Wet-Lettuce-Robocup/robot_pcb/README.md

# Wet Lettuce Robot PCB

Kicad design file for the Wet Lettuce RoboCup Junior International robot.
