Wet-Lettuce-Robocup/robot_pcb/3dmodels/B2PS-VH_LF__SN_.stp

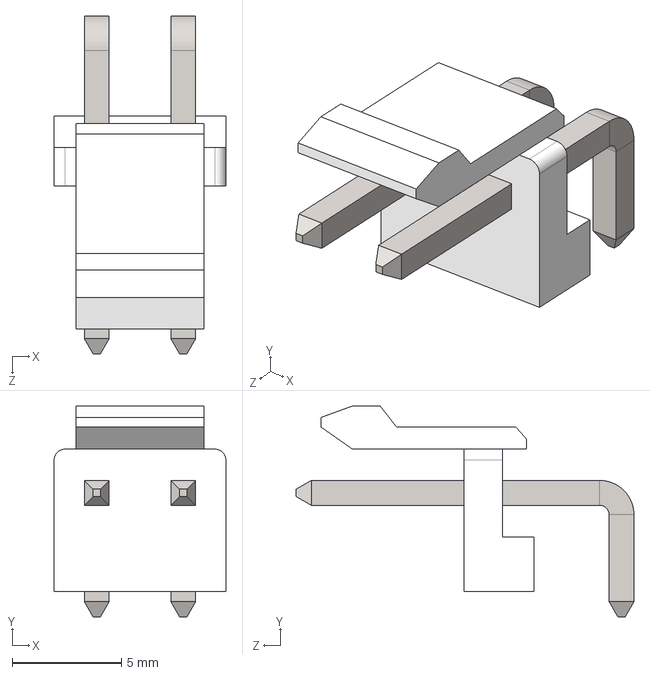
[picture p1: CAD file, 2026-03-14]
3dmodels/B2PS-VH_LF__SN_.stp
7.86 x 9.66 x 15.5 mm
