Wet-Lettuce-Robocup/robot_pcb/frontleds/frontleds.step

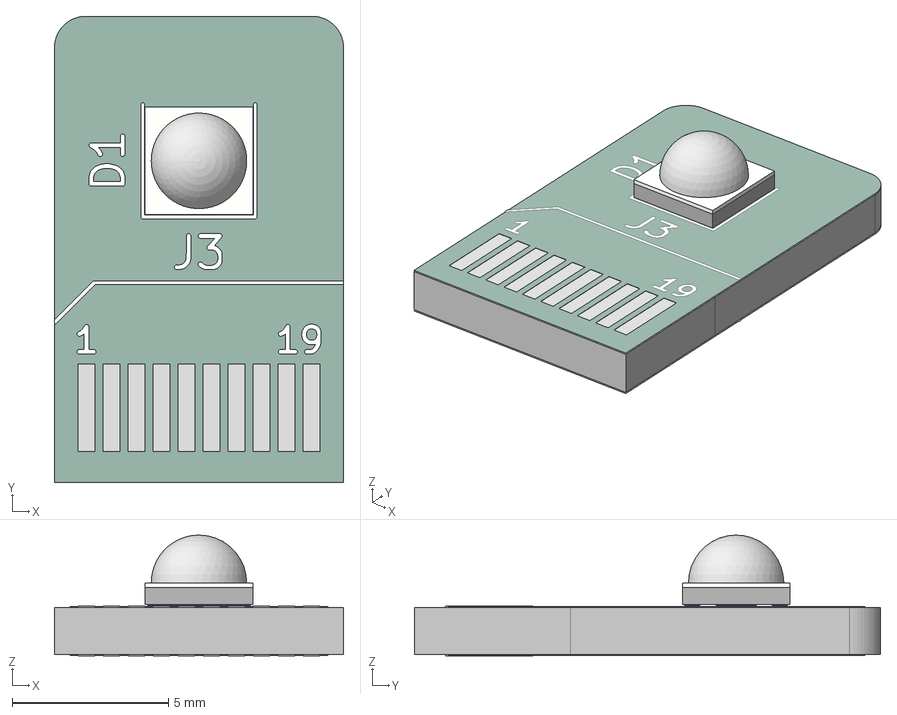
[picture p2: CAD file, 2026-03-14]
frontleds/frontleds.step
9.25 x 14.9 x 3.90 mm
LED_Cree-XP-GWT
frontleds_copper
frontleds_pad
frontleds_via
frontleds_silkscreen x 2
frontleds_soldermask x 2
frontleds_PCB
