Wet-Lettuce-Robocup/robot_pcb/3dmodels/MF-RG900-2.stp

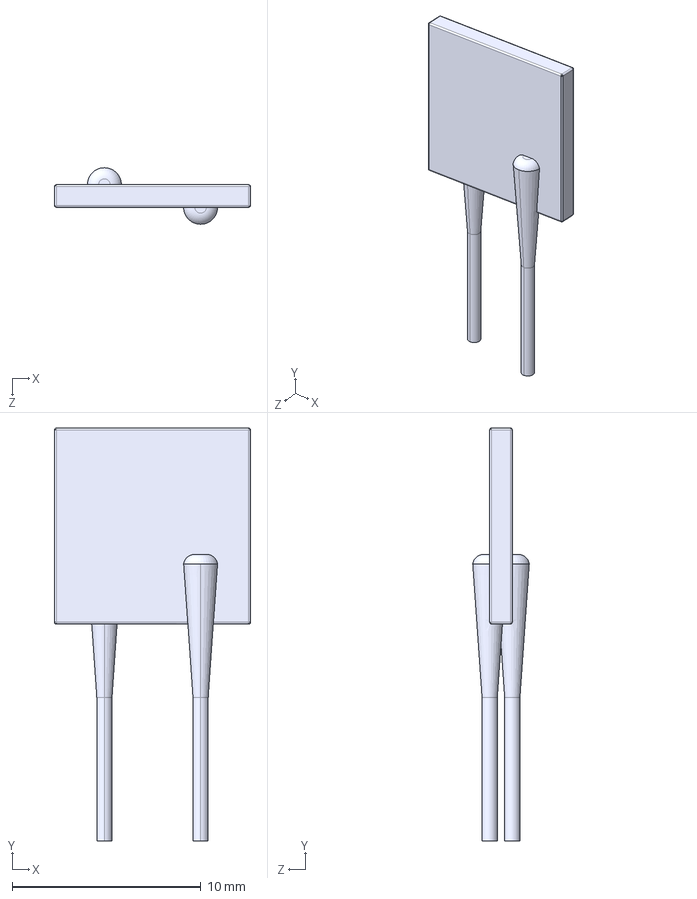
[picture p3: CAD file, 2026-03-14]
3dmodels/MF-RG900-2.stp
10.4 x 21.9 x 3.00 mm
