Wet-Lettuce-Robocup/robot_pcb/3dmodels/MF-RG900-0.stp

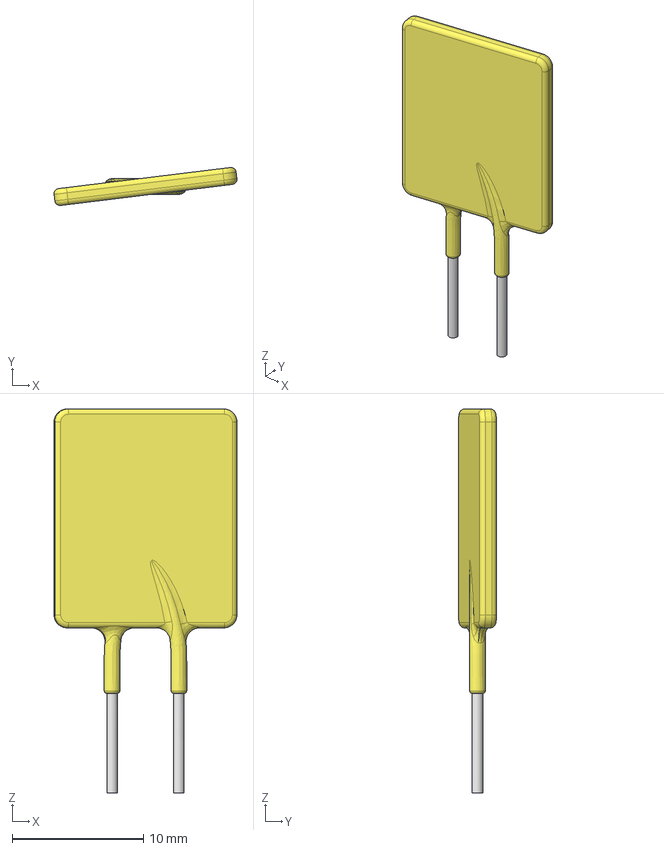
[picture p4: CAD file, 2026-03-14]
3dmodels/MF-RG900-0.stp
14.0 x 2.90 x 29.3 mm
