Wet-Lettuce-Robocup/robot_pcb/3dmodels/STCS1APUR.stp

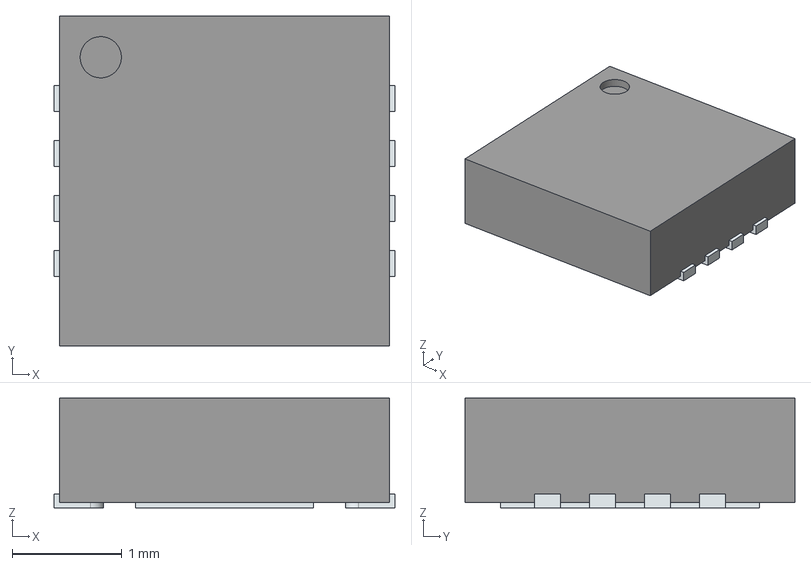
[picture p5: CAD file, 2026-03-13]
3dmodels/STCS1APUR.stp
3.10 x 3.00 x 1.00 mm
ThermalPin
PinsArrayLR
