Wet-Lettuce-Robocup/robot_pcb/3dmodels/HSEC8-110-01-S-DV-A.stp

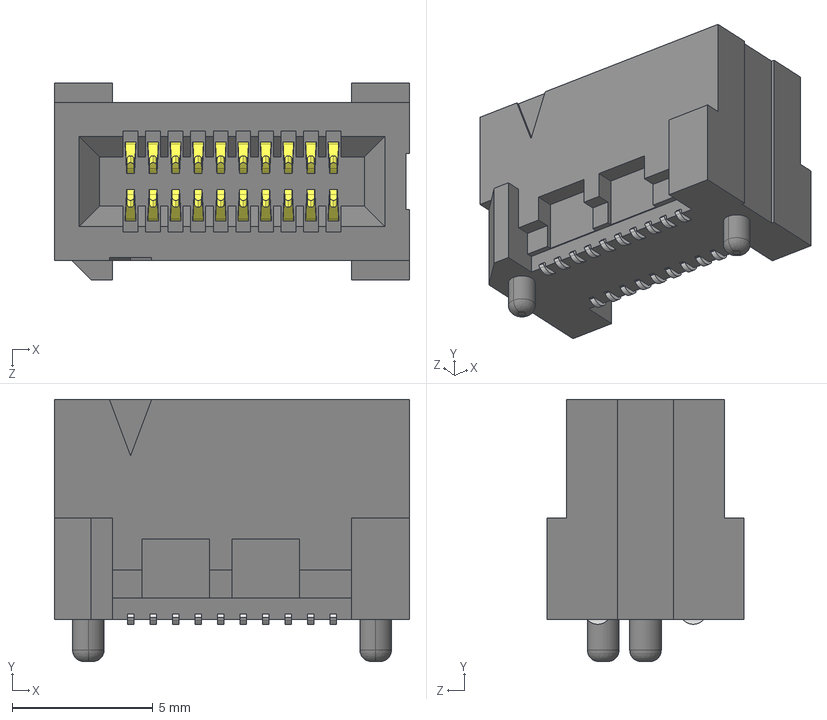
[picture p6: CAD file, 2026-03-13]
3dmodels/HSEC8-110-01-S-DV-A.stp
12.6 x 9.30 x 7.00 mm
