Wet-Lettuce-Robocup/robot_pcb/3dmodels/LED_Cree-XP-GWT.step

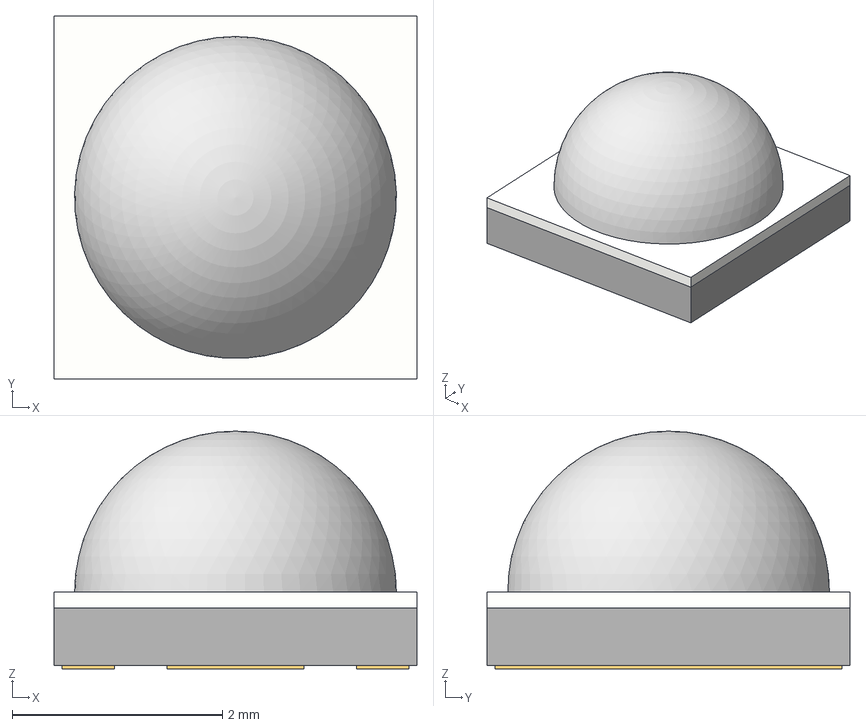
[picture p7: CAD file, 2026-03-13]
3dmodels/LED_Cree-XP-GWT.step
3.45 x 3.45 x 2.26 mm
