Wet-Lettuce-Robocup/robot_pcb/3dmodels/BNO086.stp

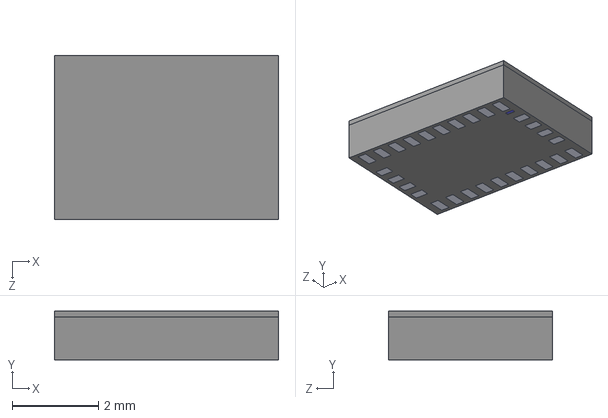
[picture p8: CAD file, 2026-02-28]
3dmodels/BNO086.stp
5.20 x 1.13 x 3.80 mm
