Wet-Lettuce-Robocup/robot_pcb/3dmodels/SIS443DN-T1-GE3.stp

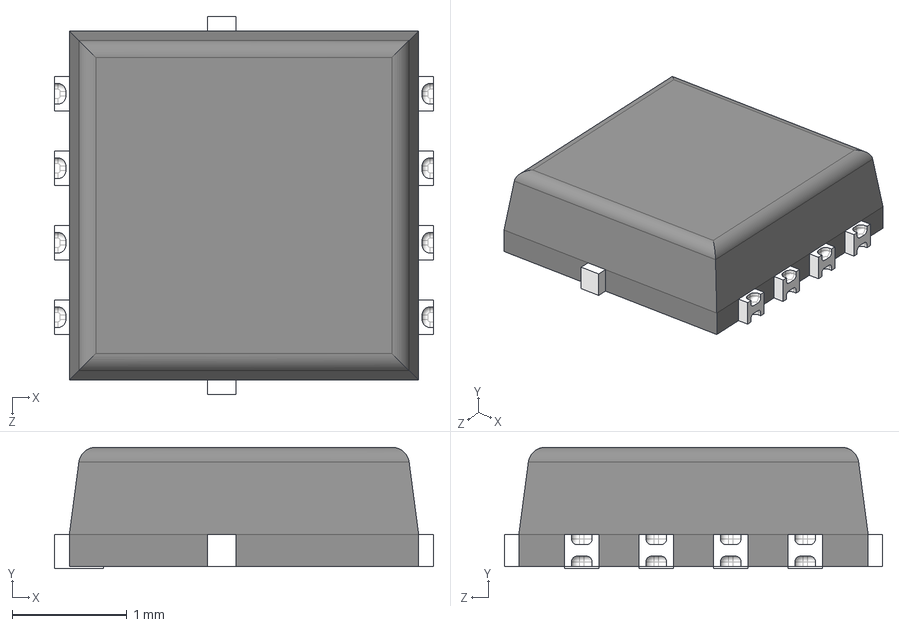
[picture p9: CAD file, 2026-02-28]
3dmodels/SIS443DN-T1-GE3.stp
3.31 x 1.06 x 3.30 mm
