Wet-Lettuce-Robocup/robot_pcb/3dmodels/IND_TAIYO_NRS8040_TAY.step

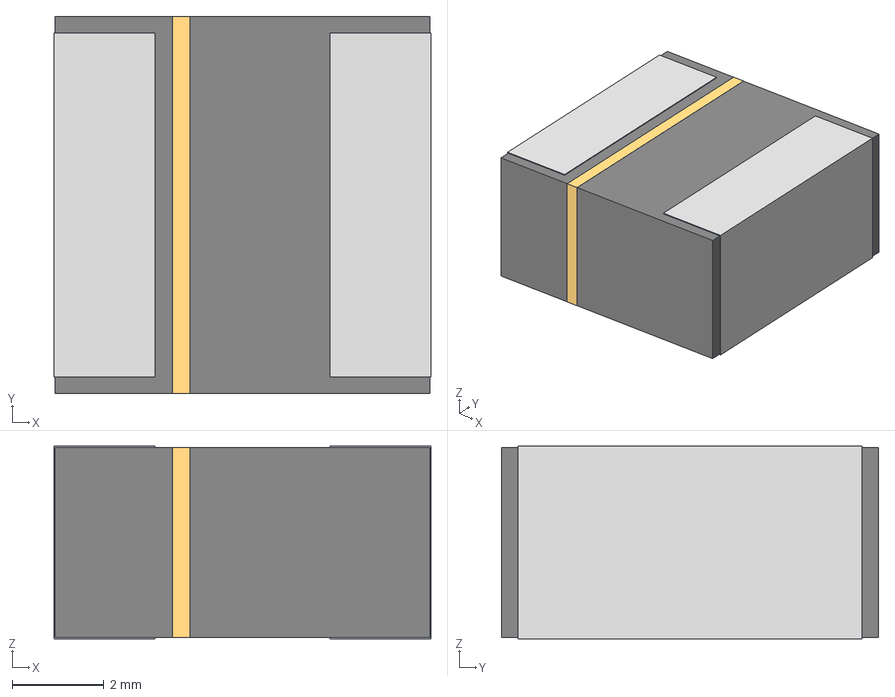
[picture p10: CAD file, 2026-02-28]
3dmodels/IND_TAIYO_NRS8040_TAY.step
8.20 x 8.21 x 4.19 mm
