Wet-Lettuce-Robocup/robot_pcb/3dmodels/POWERPAK_SO-8_SINGLE_VIS.step

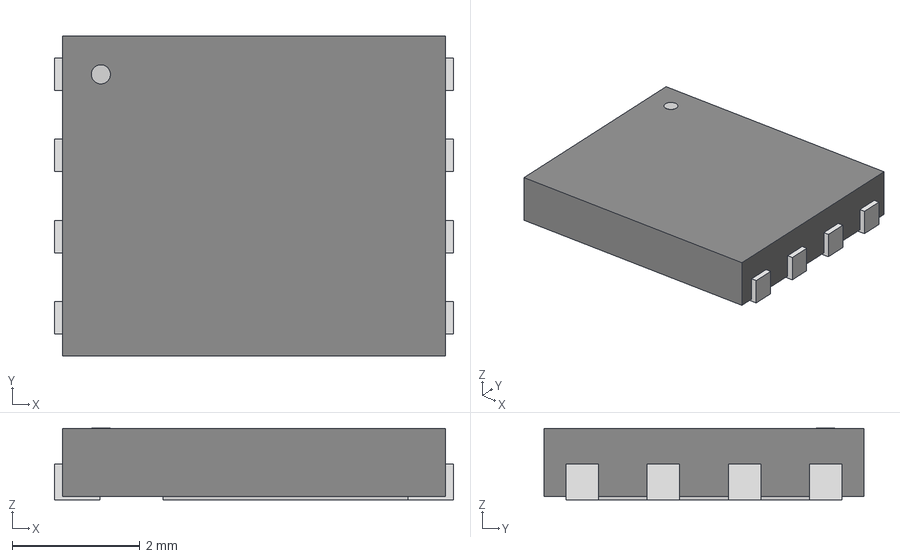
[picture p11: CAD file, 2026-02-28]
3dmodels/POWERPAK_SO-8_SINGLE_VIS.step
6.25 x 5.00 x 1.12 mm
