Wet-Lettuce-Robocup/robot_pcb/3dmodels/CYPD3175-24LQXQ.stp

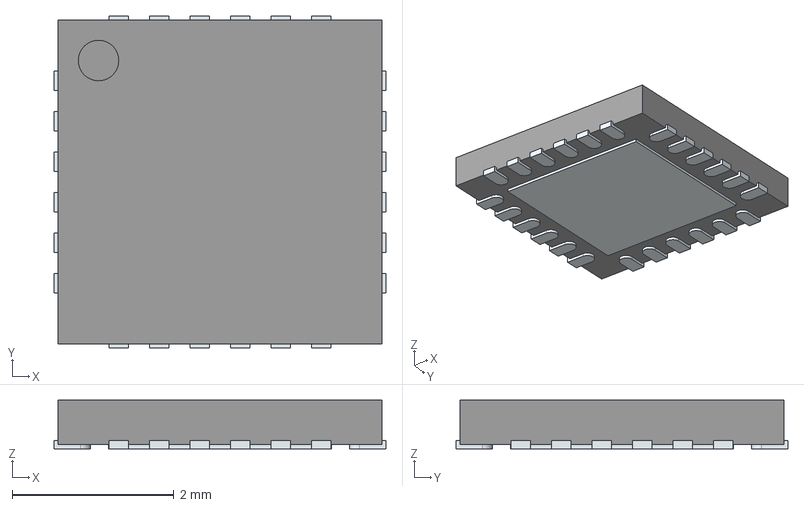
[picture p12: CAD file, 2026-02-28]
3dmodels/CYPD3175-24LQXQ.stp
4.10 x 4.10 x 0.6 mm
ThermalPin
PinsArrayLR
PinsArrayTB
