Wet-Lettuce-Robocup/robot_pcb/3dmodels/IND_CYA0630_SHH.step

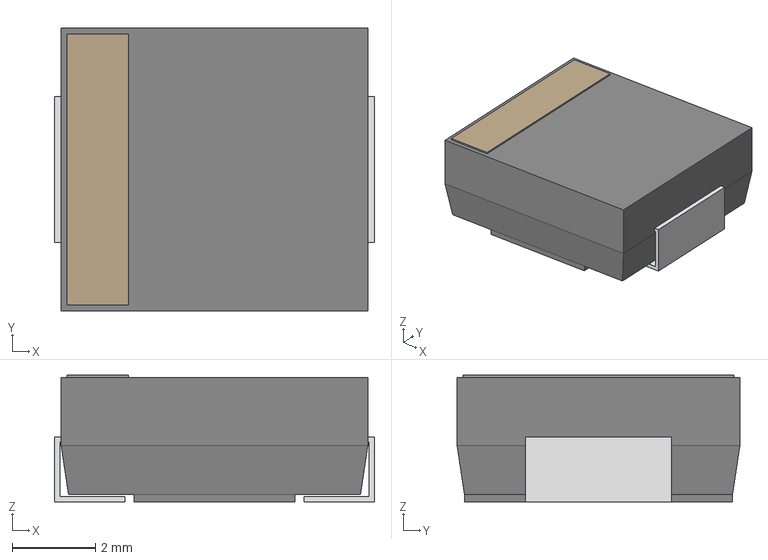
[picture p13: CAD file, 2026-02-28]
3dmodels/IND_CYA0630_SHH.step
7.70 x 6.81 x 3.05 mm
