Wet-Lettuce-Robocup/robot_pcb/3dmodels/RHA0040P.stp

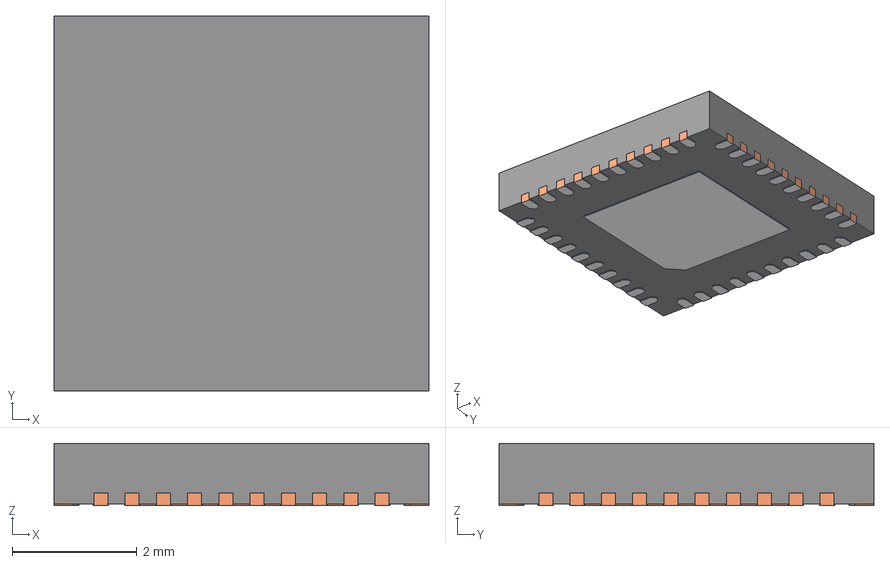
[picture p14: CAD file, 2026-02-28]
3dmodels/RHA0040P.stp
6.00 x 6.00 x 1.00 mm
BODY-QFN
FRAME-RHA0040P
