Wet-Lettuce-Robocup/robot_pcb/3dmodels/IAUCN04S7L028ATMA1.stp

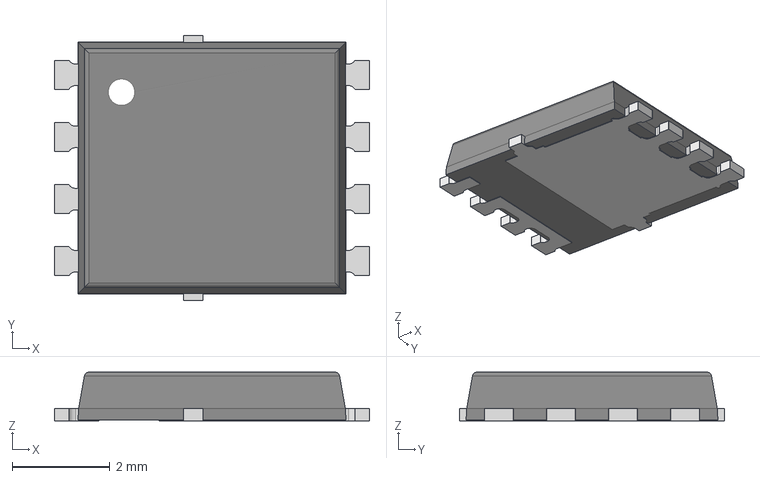
[picture p15: CAD file, 2026-02-28]
3dmodels/IAUCN04S7L028ATMA1.stp
6.44 x 5.41 x 1.00 mm
