Wet-Lettuce-Robocup/robot_pcb/3dmodels/MLC7540-142MEB.stp

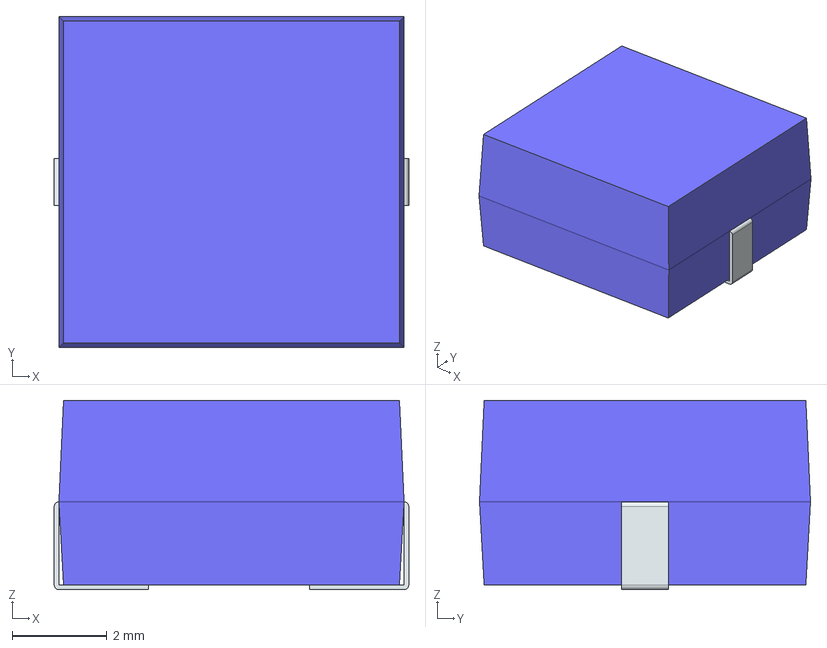
[picture p16: CAD file, 2026-02-26]
3dmodels/MLC7540-142MEB.stp
7.50 x 7.00 x 4.00 mm
FilletPin1
FilletPin2
