Wet-Lettuce-Robocup/robot_pcb/3dmodels/RNW0013A.stp

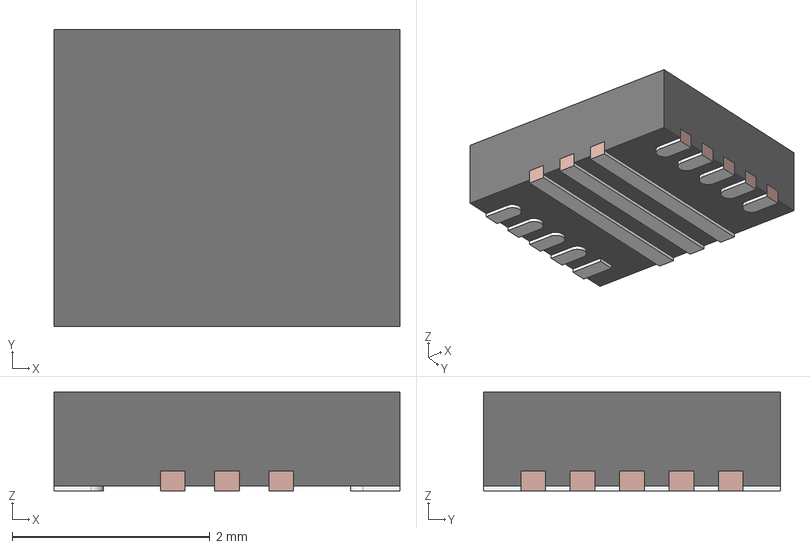
[picture p17: CAD file, 2026-02-26]
3dmodels/RNW0013A.stp
3.50 x 3.00 x 1.00 mm
BODY-SON
FRAME-RNW0013A
PIN1-ID
