Wet-Lettuce-Robocup/robot_pcb/robot_pcb.kicad_pcb

## KiCad design robot_pcb.kicad_pcb (2026-04-24)

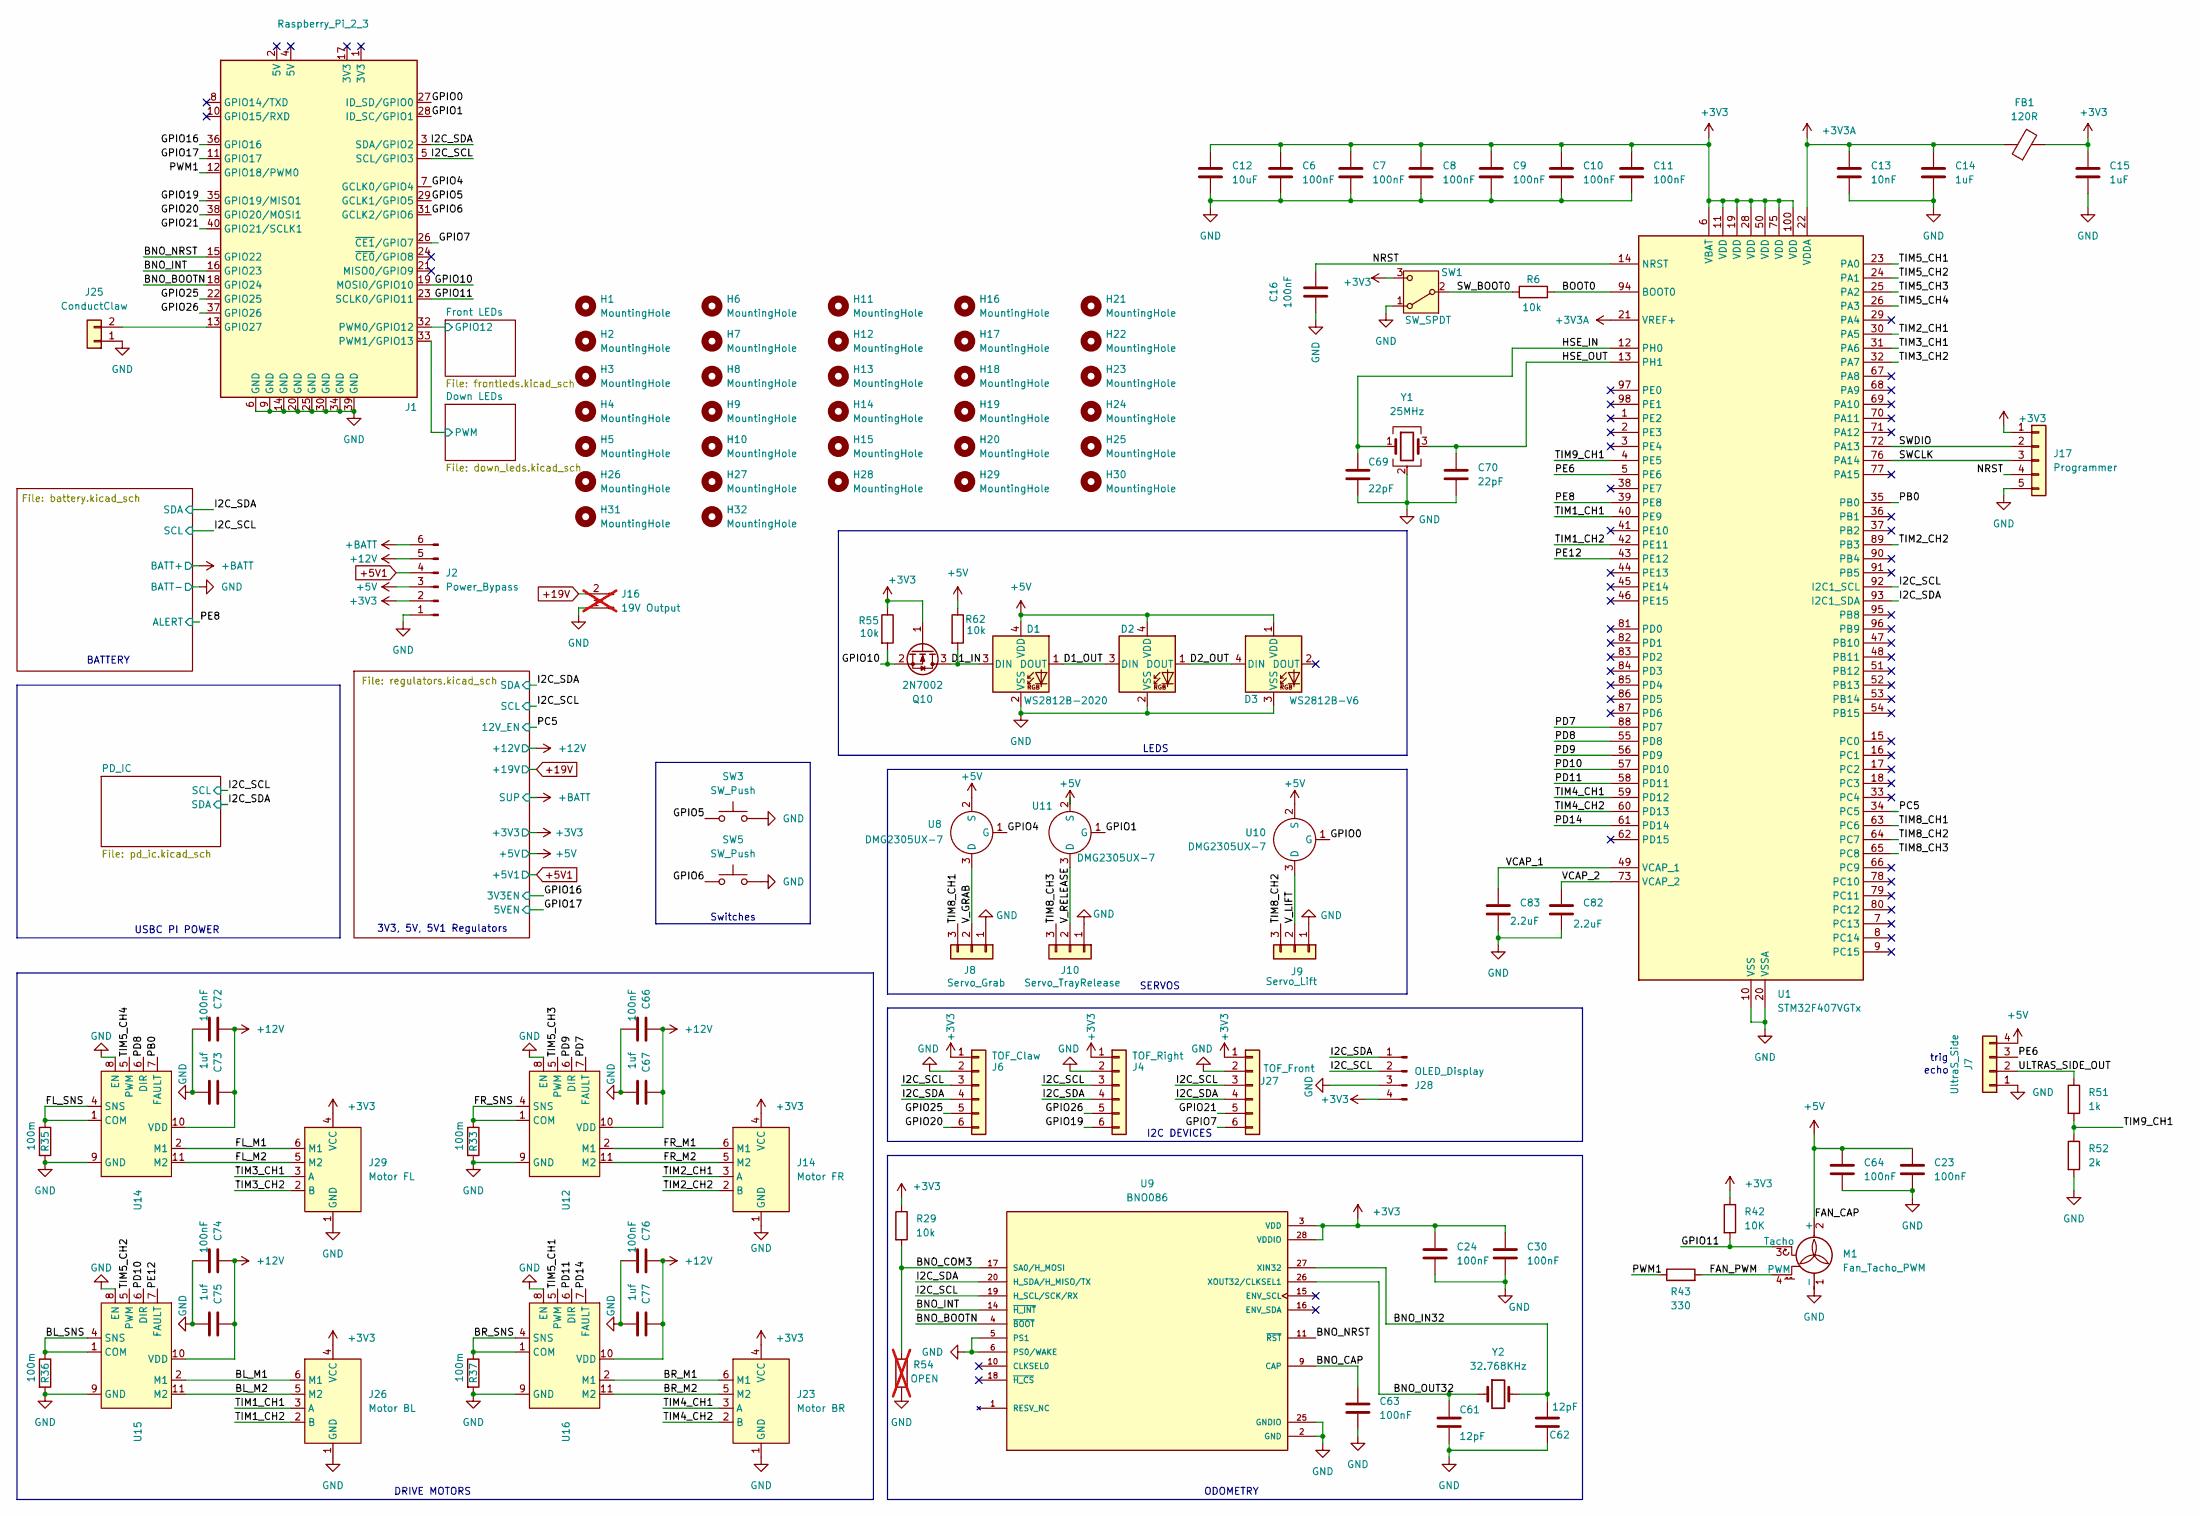
[picture p18: schematic robot_pcb.kicad_sch, Dry Lettuce Robot]

Parts:
C6, C7, C8, C9, C10, C11, C16, C23, C24, C30, C63, C64: 100nF; C_0402_1005Metric; LCSC C307331
C12: 10uF; C_0603_1608Metric; LCSC C96446
C13: 10nF; C_0402_1005Metric; LCSC C15195
C14, C15: 1uF; C_0402_1005Metric; LCSC C52923
C61, C62: 12pF; C_0402_1005Metric; LCSC C76948
C66, C72, C74, C76: 100nF; C_0603_1608Metric; LCSC C14663
C67, C73, C75, C77: 1uf; C_0603_1608Metric; LCSC C29936
C69, C70: 22pF; C_0402_1005Metric; LCSC C76960
C82, C83: 2.2uF; C_0603_1608Metric; LCSC C23630
D1, D2: WS2812B-2020; LED_WS2812B-2020_PLCC4_2.0x2.0mm; LCSC C965555
D3: WS2812B-V6; LED_WS2812B_PLCC4_5.0x5.0mm_P3.2mm; LCSC C52917433
FB1: 120R; L_0603_1608Metric; LCSC C113030
H1, H2, H3, H4, H13, H14, H15, H20, H21, H22, H23, H30: MountingHole; MountingHole_3.2mm_M3_DIN965_Pad_TopBottom
H5, H6, H7, H8, H18, H19, H28, H29: MountingHole; MountingHole_2.2mm_M2_DIN965_Pad_TopBottom
H9, H10, H11, H12, H16, H17, H24, H25, H26, H27, H31, H32: MountingHole; MountingHole_2.7mm_M2.5_DIN965_Pad_TopBottom
J1: Raspberry_Pi_2_3; PinHeader_2x20_P2.54mm_Vertical; LCSC C50980
J2: Power_Bypass; PinHeader_1x06_P2.54mm_Vertical; LCSC C52016393
J4: TOF_Right; JST_PH_B6B-PH-K_1x06_P2.00mm_Vertical; LCSC C495261
J6: TOF_Claw; JST_PH_B6B-PH-K_1x06_P2.00mm_Vertical; LCSC C495261
J7: UltraS_Side; PinHeader_1x04_P2.54mm_Vertical; LCSC C541851
J8: Servo_Grab; JST_PH_B3B-PH-K_1x03_P2.00mm_Vertical; LCSC C158004
J9: Servo_Lift; JST_PH_B3B-PH-K_1x03_P2.00mm_Vertical; LCSC C158004
J10: Servo_TrayRelease; JST_PH_B3B-PH-K_1x03_P2.00mm_Vertical; LCSC C158004
J14: Motor FR; JST_PH_S6B-PH-K_1x06_P2.00mm_Horizontal; LCSC C157920
J16: 19V Output; JST_VH_B2PS-VH_1x02_P3.96mm_Horizontal; LCSC C158007; not fitted
J17: Programmer; PinHeader_1x05_P2.54mm_Vertical; LCSC C42431835
J23: Motor BR; JST_PH_S6B-PH-K_1x06_P2.00mm_Horizontal; LCSC C157920
J25: ConductClaw; JST_PH_B2B-PH-K_1x02_P2.00mm_Vertical; LCSC C5251182
J26: Motor BL; JST_PH_S6B-PH-K_1x06_P2.00mm_Horizontal; LCSC C157920
J27: TOF_Front; JST_PH_B6B-PH-K_1x06_P2.00mm_Vertical; LCSC C495261
J28: OLED_Display; OLED_small; LCSC C2718488
J29: Motor FL; JST_PH_S6B-PH-K_1x06_P2.00mm_Horizontal; LCSC C157920
M1: Fan_Tacho_PWM; FanPinHeader_1x04_P2.54mm_Vertical; LCSC C240840
Q10: 2N7002; SOT-23; LCSC C65189
R6, R29, R55, R62: 10k; R_0402_1005Metric; LCSC C60490
R33, R35, R36, R37: 100m; R_1206_3216Metric; LCSC C3033268
R42: 10K; R_0402_1005Metric; LCSC C60490
R43: 330; R_0402_1005Metric; LCSC C105875
R51: 1k; R_0603_1608Metric; LCSC C22548
R52: 2k; R_0603_1608Metric; LCSC C105576
R54: OPEN; R_0402_1005Metric; not fitted
SW1: SW_SPDT; SW_Slide_SPDT_Straight_CK_OS102011MS2Q; LCSC C221829
SW3, SW5: SW_Push; SW_Push_1P1T_NO_CK_new; LCSC C431539
U1: STM32F407VGTx; LQFP-100_14x14mm_P0.5mm; LCSC C720656
U8, U10, U11: DMG2305UX-7; TSOT-23; LCSC C150470
U9: BNO086; IC_BNO086; PARTREV v1.17; LCSC C5264422
U12, U14, U15, U16: Maxim_TDFN-12-1EP_3x3mm_P0.5mm_EP1.7x2.5mm; LCSC C194048
Y1: 25MHz; Crystal_SMD_3225-4Pin_3.2x2.5mm; LCSC C5444544
Y2: 32.768KHz; Crystal_SMD_3215-2Pin_3.2x1.5mm; LCSC C99010

Connections:
+3V3: C6.1, C7.1, C8.1, C9.1, C10.1, C11.1, C12.1, C15.1, C24.1, C30.1, FB1.2, J2.2, J4.1, J6.1, J14.4 (VCC), J17.1, J23.4 (VCC), J26.4 (VCC), J27.1, J28.4, J29.4 (VCC), Q10.1 (G), R29.1, R42.1, R55.1, SW1.3 (C), U1.6 (VBAT), U1.11 (VDD), U1.19 (VDD), U1.28 (VDD), U1.50 (VDD), U1.75 (VDD), U1.100 (VDD), U9.3 (VDD), U9.28 (VDDIO); also elsewhere on the board
+3V3A: C13.1, C14.1, FB1.1, U1.21 (VREF+), U1.22 (VDDA)
+5V: C23.1, C64.1, D1.4 (VDD), D2.4 (VDD), D3.1 (VDD), J2.3, J7.4, M1.2 (+), R62.1, U8.2 (S), U10.2 (S), U11.2 (S); also elsewhere on the board
+5V1: J2.4; also elsewhere on the board
+12V: C66.1, C67.1, C72.1, C73.1, C74.1, C75.1, C76.1, C77.1, J2.5, U12.3 (VDD), U12.10 (VDD), U14.3 (VDD), U14.10 (VDD), U15.3 (VDD), U15.10 (VDD), U16.3 (VDD), U16.10 (VDD); also elsewhere on the board
+19V: J16.2; also elsewhere on the board
+BATT: J2.6; also elsewhere on the board
/BL_M1: J26.6 (M1), U15.2 (M1)
/BL_M2: J26.5 (M2), U15.11 (M2)
/BL_SNS: R36.1, U15.1 (COM), U15.4 (SNS), U15.12 (COM)
/BNO_BOOTN: J1.18 (GPIO24), U9.4 (~BOOT)
/BNO_CAP: C63.1, U9.9 (CAP)
/BNO_COM3: R29.2, R54.1, U9.17 (SA0/H_MOSI)
/BNO_IN32: C62.1, U9.27 (XIN32), Y2.2
/BNO_INT: J1.16 (GPIO23), U9.14 (~H_INT)
/BNO_NRST: J1.15 (GPIO22), U9.11 (~RST)
/BNO_OUT32: C61.1, U9.26 (XOUT32/CLKSEL1), Y2.1
/BOOT0: R6.2, U1.94 (BOOT0)
/BR_M1: J23.6 (M1), U16.2 (M1)
/BR_M2: J23.5 (M2), U16.11 (M2)
/BR_SNS: R37.1, U16.1 (COM), U16.4 (SNS), U16.12 (COM)
/D1_IN: D1.3 (DIN), Q10.3 (D), R62.2
/D1_OUT: D1.1 (DOUT), D2.3 (DIN)
/D2_OUT: D2.1 (DOUT), D3.4 (DIN)
/Down LEDs/PWM: J1.33 (PWM1/GPIO13); also elsewhere on the board
/FAN_PWM: M1.4 (PWM), R43.2
/FL_M1: J29.6 (M1), U14.2 (M1)
/FL_M2: J29.5 (M2), U14.11 (M2)
/FL_SNS: R35.1, U14.1 (COM), U14.4 (SNS), U14.12 (COM)
/FR_M1: J14.6 (M1), U12.2 (M1)
/FR_M2: J14.5 (M2), U12.11 (M2)
/FR_SNS: R33.1, U12.1 (COM), U12.4 (SNS), U12.12 (COM)
/Front LEDs/GPIO12: J1.32 (PWM0/GPIO12); also elsewhere on the board
/GPIO0: J1.27 (ID_SD/GPIO0), U10.1 (G)
/GPIO1: J1.28 (ID_SC/GPIO1), U11.1 (G)
/GPIO4: J1.7 (GCLK0/GPIO4), U8.1 (G)
/GPIO5: J1.29 (GCLK1/GPIO5), SW3.1
/GPIO6: J1.31 (GCLK2/GPIO6), SW5.1
/GPIO7: J1.26 (~CE1/GPIO7), J27.6
/GPIO10: J1.19 (MOSI0/GPIO10), Q10.2 (S), R55.2
/GPIO11: J1.23 (SCLK0/GPIO11), M1.3 (Tacho), R42.2
/GPIO16: J1.36 (GPIO16); also elsewhere on the board
/GPIO17: J1.11 (GPIO17); also elsewhere on the board
/GPIO19: J1.35 (GPIO19/MISO1), J4.6
/GPIO20: J1.38 (GPIO20/MOSI1), J6.6
/GPIO21: J1.40 (GPIO21/SCLK1), J27.5
/GPIO25: J1.22 (GPIO25), J6.5
/GPIO26: J1.37 (GPIO26), J4.5
/HSE_IN: C69.1, U1.12 (PH0), Y1.1
/HSE_OUT: C70.1, U1.13 (PH1), Y1.3
/I2C_SCL: J1.5 (SCL/GPIO3), J4.3, J6.3, J27.3, J28.2, U1.92 (I2C1_SCL), U9.19 (H_SCL/SCK/RX); also elsewhere on the board
/I2C_SDA: J1.3 (SDA/GPIO2), J4.4, J6.4, J27.4, J28.1, U1.93 (I2C1_SDA), U9.20 (H_SDA/H_MISO/TX); also elsewhere on the board
/NRST: C16.2, J17.4, U1.14 (NRST)
/PB0: U1.35 (PB0), U14.7 (FAULT)
/PC5: U1.34 (PC5); also elsewhere on the board
/PD7: U1.88 (PD7), U12.7 (FAULT)
/PD8: U1.55 (PD8), U14.6 (DIR)
/PD9: U1.56 (PD9), U12.6 (DIR)
/PD10: U1.57 (PD10), U15.6 (DIR)
/PD11: U1.58 (PD11), U16.6 (DIR)
/PD14: U1.61 (PD14), U16.7 (FAULT)
/PE6: J7.3, U1.5 (PE6)
/PE8: U1.39 (PE8); also elsewhere on the board
/PE12: U1.43 (PE12), U15.7 (FAULT)
/PWM1: J1.12 (GPIO18/PWM0), R43.1
/SWCLK: J17.3, U1.76 (PA14)
/SWDIO: J17.2, U1.72 (PA13)
/SW_BOOT0: R6.1, SW1.2 (B)
/TIM1_CH1: J26.3 (A), U1.40 (PE9)
/TIM1_CH2: J26.2 (B), U1.42 (PE11)
/TIM2_CH1: J14.3 (A), U1.30 (PA5)
/TIM2_CH2: J14.2 (B), U1.89 (PB3)
/TIM3_CH1: J29.3 (A), U1.31 (PA6)
/TIM3_CH2: J29.2 (B), U1.32 (PA7)
/TIM4_CH1: J23.3 (A), U1.59 (PD12)
/TIM4_CH2: J23.2 (B), U1.60 (PD13)
/TIM5_CH1: U1.23 (PA0), U16.5 (PWM)
/TIM5_CH2: U1.24 (PA1), U15.5 (PWM)
/TIM5_CH3: U1.25 (PA2), U12.5 (PWM)
/TIM5_CH4: U1.26 (PA3), U14.5 (PWM)
/TIM8_CH1: J8.3, U1.63 (PC6)
/TIM8_CH2: J9.3, U1.64 (PC7)
/TIM8_CH3: J10.3, U1.65 (PC8)
/TIM9_CH1: R51.2, R52.1, U1.4 (PE5)
/ULTRAS_SIDE_OUT: J7.2, R51.1
/VCAP_1: C83.1, U1.49 (VCAP_1)
/VCAP_2: C82.1, U1.73 (VCAP_2)
/V_GRAB: J8.2, U8.3 (D)
/V_LIFT: J9.2, U10.3 (D)
/V_RELEASE: J10.2, U11.3 (D)
GND: C6.2, C7.2, C8.2, C9.2, C10.2, C11.2, C12.2, C13.2, C14.2, C15.2, C16.1, C23.2, C24.2, C30.2, C61.2, C62.2, C63.2, C64.2, C66.2, C67.2, C69.2, C70.2, C72.2, C73.2, C74.2, C75.2, C76.2, C77.2, C82.2, C83.2, D1.2 (VSS), D2.2 (VSS), D3.3 (VSS), J1.6 (GND), J1.9 (GND), J1.14 (GND), J1.20 (GND), J1.25 (GND), J1.30 (GND), J1.34 (GND), J1.39 (GND), J2.1, J4.2, J6.2, J7.1, J8.1, J9.1, J10.1, J14.1 (GND), J16.1, J17.5, J23.1 (GND), J25.1, J26.1 (GND), J27.2, J28.3, J29.1 (GND), M1.1 (-), R33.2, R35.2, R36.2, R37.2, R52.2, R54.2, SW1.1 (A), SW3.2, SW5.2, U1.10 (VSS), U1.20 (VSSA), U1.27 (VSS), U1.74 (VSS), U1.99 (VSS), U9.2 (GND), U9.5 (PS1), U9.6 (PS0/WAKE), U9.25 (GNDIO), U12.8 (EN), U12.9 (GND), U12.13 (PAD), U14.8 (EN), U14.9 (GND), U14.13 (PAD), U15.8 (EN), U15.9 (GND), U15.13 (PAD), U16.8 (EN), U16.9 (GND), U16.13 (PAD), Y1.2 (G), Y1.4 (G); also elsewhere on the board
unnamed: J1.13 (GPIO27), J25.2

Notes on the sheet:
LEDS
ODOMETRY
trig
SERVOS
USBC PI POWER
DRIVE MOTORS
BATTERY
3V3, 5V, 5V1 Regulators
Switches
I2C DEVICES
echo

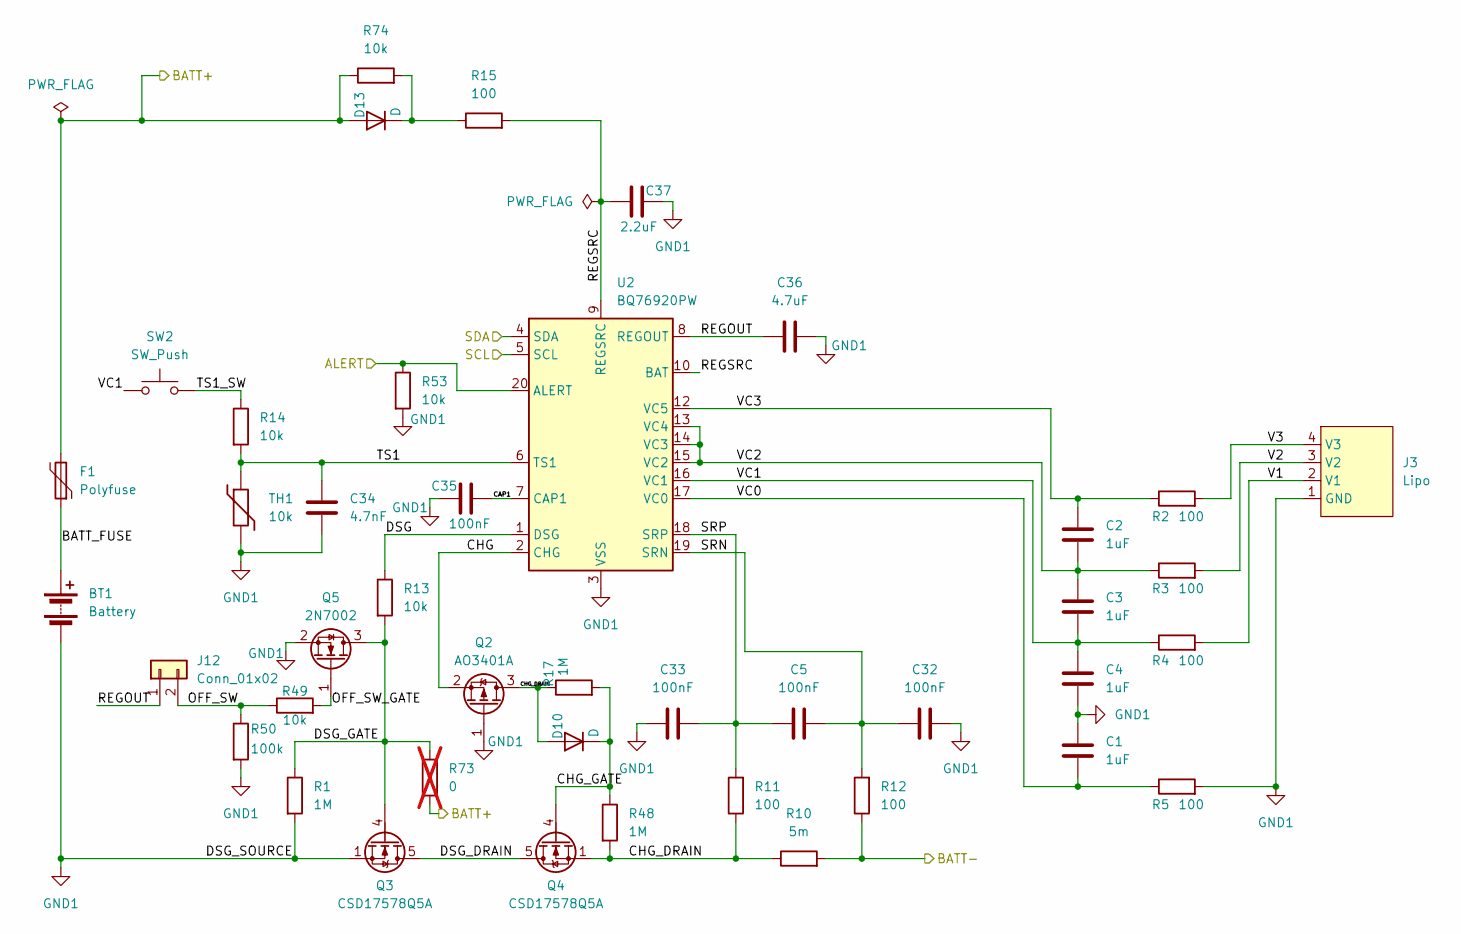
[picture p19: schematic battery.kicad_sch]

Parts:
BT1: Battery; AMASS_XT60-M_1x02_P7.20mm_Vertical; LCSC C98733
C1, C2, C3, C4: 1uF; C_0402_1005Metric; LCSC C52923
C5, C32, C33, C35: 100nF; C_0402_1005Metric; LCSC C307331
C34: 4.7nF; C_0402_1005Metric; LCSC C84705
C36: 4.7uF; C_0603_1608Metric; LCSC C69335
C37: 2.2uF; C_0402_1005Metric; LCSC C307418
D10, D13: D; D_0603_1608Metric; LCSC C35621074
F1: Polyfuse; Fuse_Bourns_MF-RG900; LCSC C3762600
J3: Lipo; JST_XH_B4B-XH-A_1x04_P2.50mm_Vertical; LCSC C594232
J12: Conn_01x02; JST_PH_S2B-PH-K_1x02_P2.00mm_Horizontal; LCSC C173752
Q2: AO3401A; SOT-23; LCSC C15127
Q3, Q4: CSD17578Q5A; TDSON-8-1; LCSC C2871447
Q5: 2N7002; SOT-23; LCSC C65189
R1, R17, R48: 1M; R_0402_1005Metric; LCSC C138033
R2, R3, R4, R5: 100; R_0805_2012Metric; LCSC C105577
R10: 5m; R_2512_6332Metric; LCSC C2903482
R11, R12: 100; R_0603_1608Metric; LCSC C105588
R13, R14, R49, R53, R74: 10k; R_0402_1005Metric; LCSC C60490
R15: 100; R_1206_3216Metric; LCSC C2907369
R50: 100k; R_0402_1005Metric; LCSC C60491
R73: 0; R_0402_1005Metric; LCSC C60490; not fitted
SW2: SW_Push; SW_Push_1P1T_NO_CK_new; LCSC C431539
TH1: 10k; R_0402_1005Metric; LCSC C209959
U2: BQ76920PW; TSSOP-20_4.4x6.5mm_P0.65mm; LCSC C601650

Connections:
+BATT: D13.2 (A), F1.2, R73.2, R74.1; also elsewhere on the board
/Battery/BATT_FUSE: BT1.1 (+), F1.1
/Battery/CAP1: C35.2, U2.7 (CAP1)
/Battery/CHG: Q2.2 (S), U2.2 (CHG)
/Battery/CHG_DRAIN: D10.2 (A), Q2.3 (D), Q4.1 (S), Q4.2 (S), Q4.3 (S), R10.1, R11.1, R17.1, R48.2
/Battery/CHG_GATE: D10.1 (K), Q4.4 (G), R17.2, R48.1
/Battery/DSG: R13.1, U2.1 (DSG)
/Battery/DSG_DRAIN: Q3.5 (D), Q4.5 (D)
/Battery/DSG_GATE: Q3.4 (G), Q5.3 (D), R1.1, R13.2, R73.1
/Battery/OFF_SW: J12.2, R49.1, R50.1
/Battery/OFF_SW_GATE: Q5.1 (G), R49.2
/Battery/REGOUT: C36.1, J12.1, U2.8 (REGOUT)
/Battery/REGSRC: C37.1, R15.2, U2.9 (REGSRC), U2.10 (BAT)
/Battery/SRN: C5.2, C32.1, R12.2, U2.19 (SRN)
/Battery/SRP: C5.1, C33.2, R11.2, U2.18 (SRP)
/Battery/TS1: C34.1, R14.2, TH1.1, U2.6 (TS1)
/Battery/TS1_SW: R14.1, SW2.2
/Battery/V1: J3.2 (V1), R4.2
/Battery/V2: J3.3 (V2), R3.2
/Battery/V3: J3.4 (V3), R2.2
/Battery/VC0: C1.2, R5.1, U2.17 (VC0)
/Battery/VC1: C3.2, C4.1, R4.1, SW2.1, U2.16 (VC1)
/Battery/VC2: C2.2, C3.1, R3.1, U2.13 (VC4), U2.14 (VC3), U2.15 (VC2)
/Battery/VC3: C2.1, R2.1, U2.12 (VC5)
/I2C_SCL: U2.5 (SCL); also elsewhere on the board
/I2C_SDA: U2.4 (SDA); also elsewhere on the board
/PE8: R53.1, U2.20 (ALERT); also elsewhere on the board
GND: R10.2, R12.1; also elsewhere on the board
GND1: BT1.2 (-), C1.1, C4.2, C32.2, C33.1, C34.2, C35.1, C36.2, C37.2, J3.1 (GND), Q2.1 (G), Q3.1 (S), Q3.2 (S), Q3.3 (S), Q5.2 (S), R1.2, R5.2, R50.2, R53.2, TH1.2, U2.3 (VSS)
unnamed: D13.1 (K), R15.1, R74.2

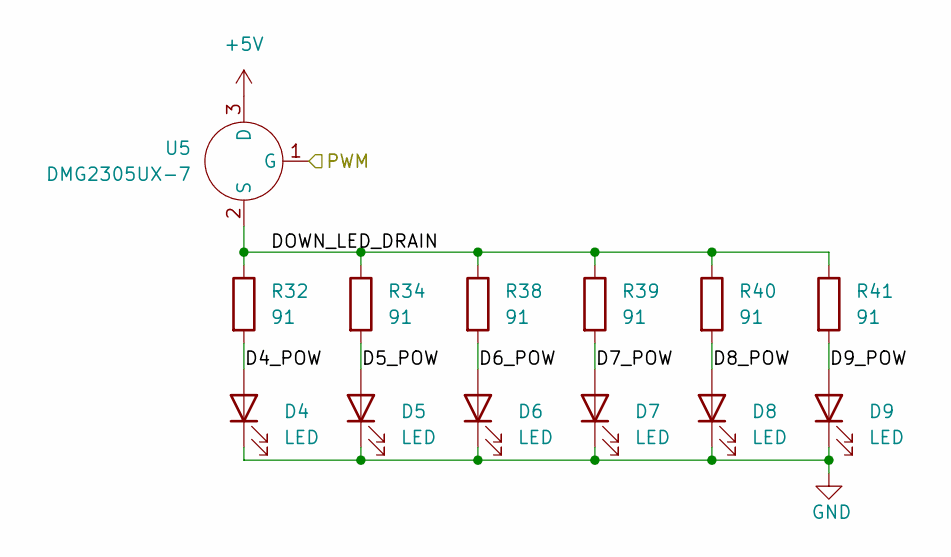
[picture p20: schematic down_leds.kicad_sch]

Parts:
D4, D5, D6, D7, D8, D9: LED; LED_PLCC_2835; LCSC C2843876
R32, R34, R38, R39, R40, R41: 91; R_1206_3216Metric; LCSC C5842965
U5: DMG2305UX-7; TSOT-23; LCSC C150470

Connections:
+5V: U5.3 (D); also elsewhere on the board
/Down LEDs/D4_POW: D4.2 (A), R32.2
/Down LEDs/D5_POW: D5.2 (A), R34.2
/Down LEDs/D6_POW: D6.2 (A), R38.2
/Down LEDs/D7_POW: D7.2 (A), R39.2
/Down LEDs/D8_POW: D8.2 (A), R40.2
/Down LEDs/D9_POW: D9.2 (A), R41.2
/Down LEDs/DOWN_LED_DRAIN: R32.1, R34.1, R38.1, R39.1, R40.1, R41.1, U5.2 (S)
/Down LEDs/PWM: U5.1 (G); also elsewhere on the board
GND: D4.1 (K), D5.1 (K), D6.1 (K), D7.1 (K), D8.1 (K), D9.1 (K); also elsewhere on the board

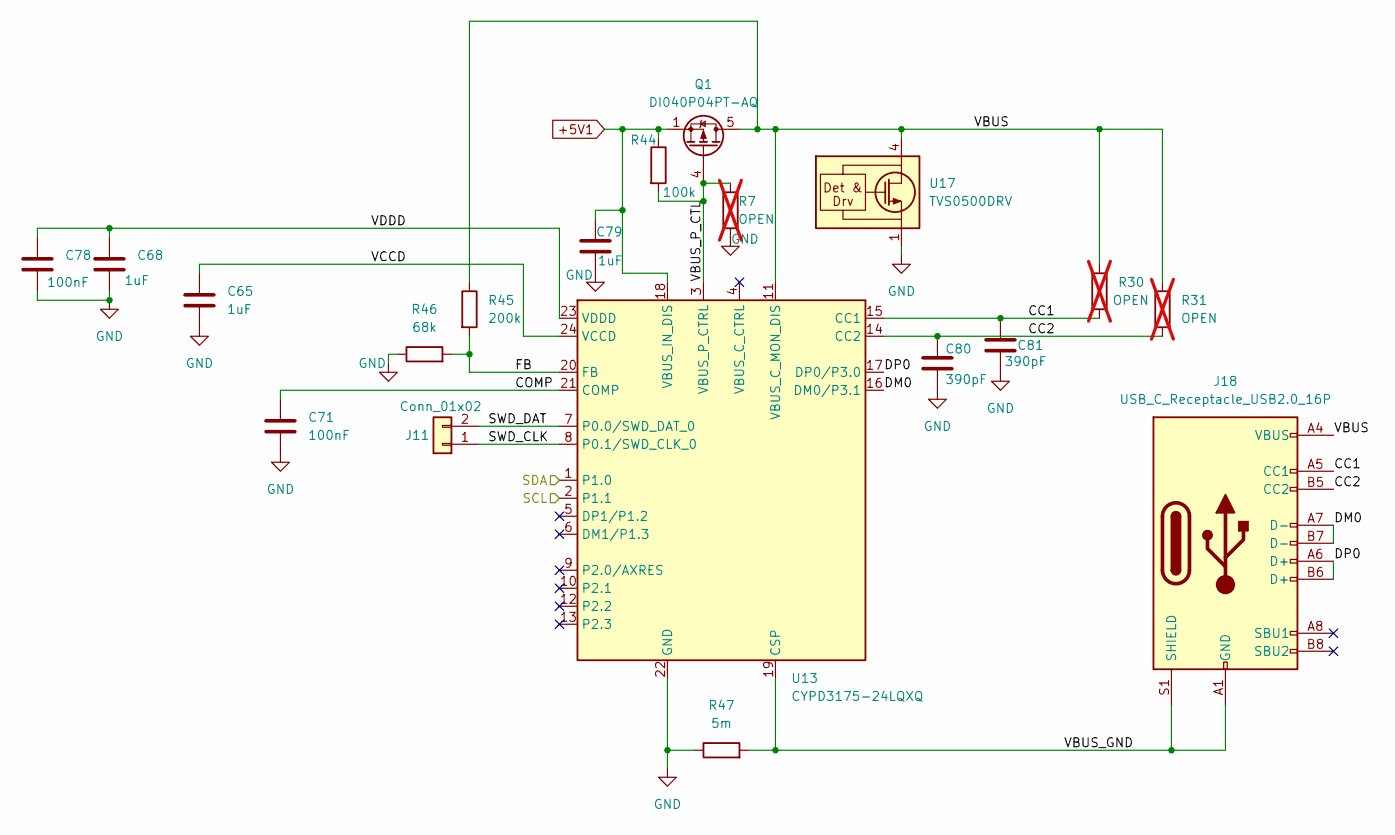
[picture p21: schematic pd_ic.kicad_sch]

Parts:
C65, C68, C79: 1uF; C_0402_1005Metric; LCSC C52923
C71, C78: 100nF; C_0402_1005Metric; LCSC C307331
C80, C81: 390pF; C_0402_1005Metric; LCSC C114397
J11: Conn_01x02; PinHeader_1x02_P2.54mm_Vertical; LCSC C52016390
J18: USB_C_Receptacle_USB2.0_16P; USB_C_Receptacle_GCT_USB4105-xx-A_16P_TopMnt_Horizontal; LCSC C3025063
Q1: DI040P04PT-AQ; Vishay_PowerPAK_1212-8_Single; LCSC C6934675
R7, R30, R31: OPEN; R_0402_1005Metric; not fitted
R44: 100k; R_0402_1005Metric; LCSC C60491
R45: 200k; R_0402_1005Metric; LCSC C114763
R46: 68k; R_0402_1005Metric; LCSC C137947
R47: 5m; R_2512_6332Metric; LCSC C2903482
U13: CYPD3175-24LQXQ; QFN-24-1EP_4x4mm_P0.5mm_EP2.75x2.75mm; LCSC C2952419
U17: TVS0500DRV; WSON-6-1EP_2x2mm_P0.65mm_EP1x1.6mm; LCSC C609571

Connections:
+5V1: C79.1, Q1.1 (S), Q1.2 (S), Q1.3 (S), R44.1, U13.18 (VBUS_IN_DIS); also elsewhere on the board
/I2C_SCL: U13.2 (P1.1); also elsewhere on the board
/I2C_SDA: U13.1 (P1.0); also elsewhere on the board
/PD_IC/CC1: C81.1, J18.A5 (CC1), R30.2, U13.15 (CC1)
/PD_IC/CC2: C80.1, J18.B5 (CC2), R31.2, U13.14 (CC2)
/PD_IC/COMP: C71.1, U13.21 (COMP)
/PD_IC/DM0: J18.A7 (D-), J18.B7 (D-), U13.16 (DM0/P3.1)
/PD_IC/DP0: J18.A6 (D+), J18.B6 (D+), U13.17 (DP0/P3.0)
/PD_IC/FB: R45.2, R46.2, U13.20 (FB)
/PD_IC/SWD_CLK: J11.1, U13.8 (P0.1/SWD_CLK_0)
/PD_IC/SWD_DAT: J11.2, U13.7 (P0.0/SWD_DAT_0)
/PD_IC/VBUS: J18.A4 (VBUS), J18.A9 (VBUS), J18.B4 (VBUS), J18.B9 (VBUS), Q1.5 (D), R30.1, R31.1, R45.1, U13.11 (VBUS_C_MON_DIS), U17.4 (IN), U17.5 (IN), U17.6 (IN)
/PD_IC/VBUS_GND: J18.A1 (GND), J18.A12 (GND), J18.B1 (GND), J18.B12 (GND), J18.S1 (SHIELD), R47.2, U13.19 (CSP)
/PD_IC/VBUS_P_CTL: Q1.4 (G), R7.1, R44.2, U13.3 (VBUS_P_CTRL)
/PD_IC/VCCD: C65.1, U13.24 (VCCD)
/PD_IC/VDDD: C68.1, C78.1, U13.23 (VDDD)
GND: C65.2, C68.2, C71.2, C78.2, C79.2, C80.2, C81.2, R7.2, R46.1, R47.1, U13.22 (GND), U13.25 (GND), U17.1 (GND), U17.2 (GND), U17.3 (GND), U17.7 (GND); also elsewhere on the board

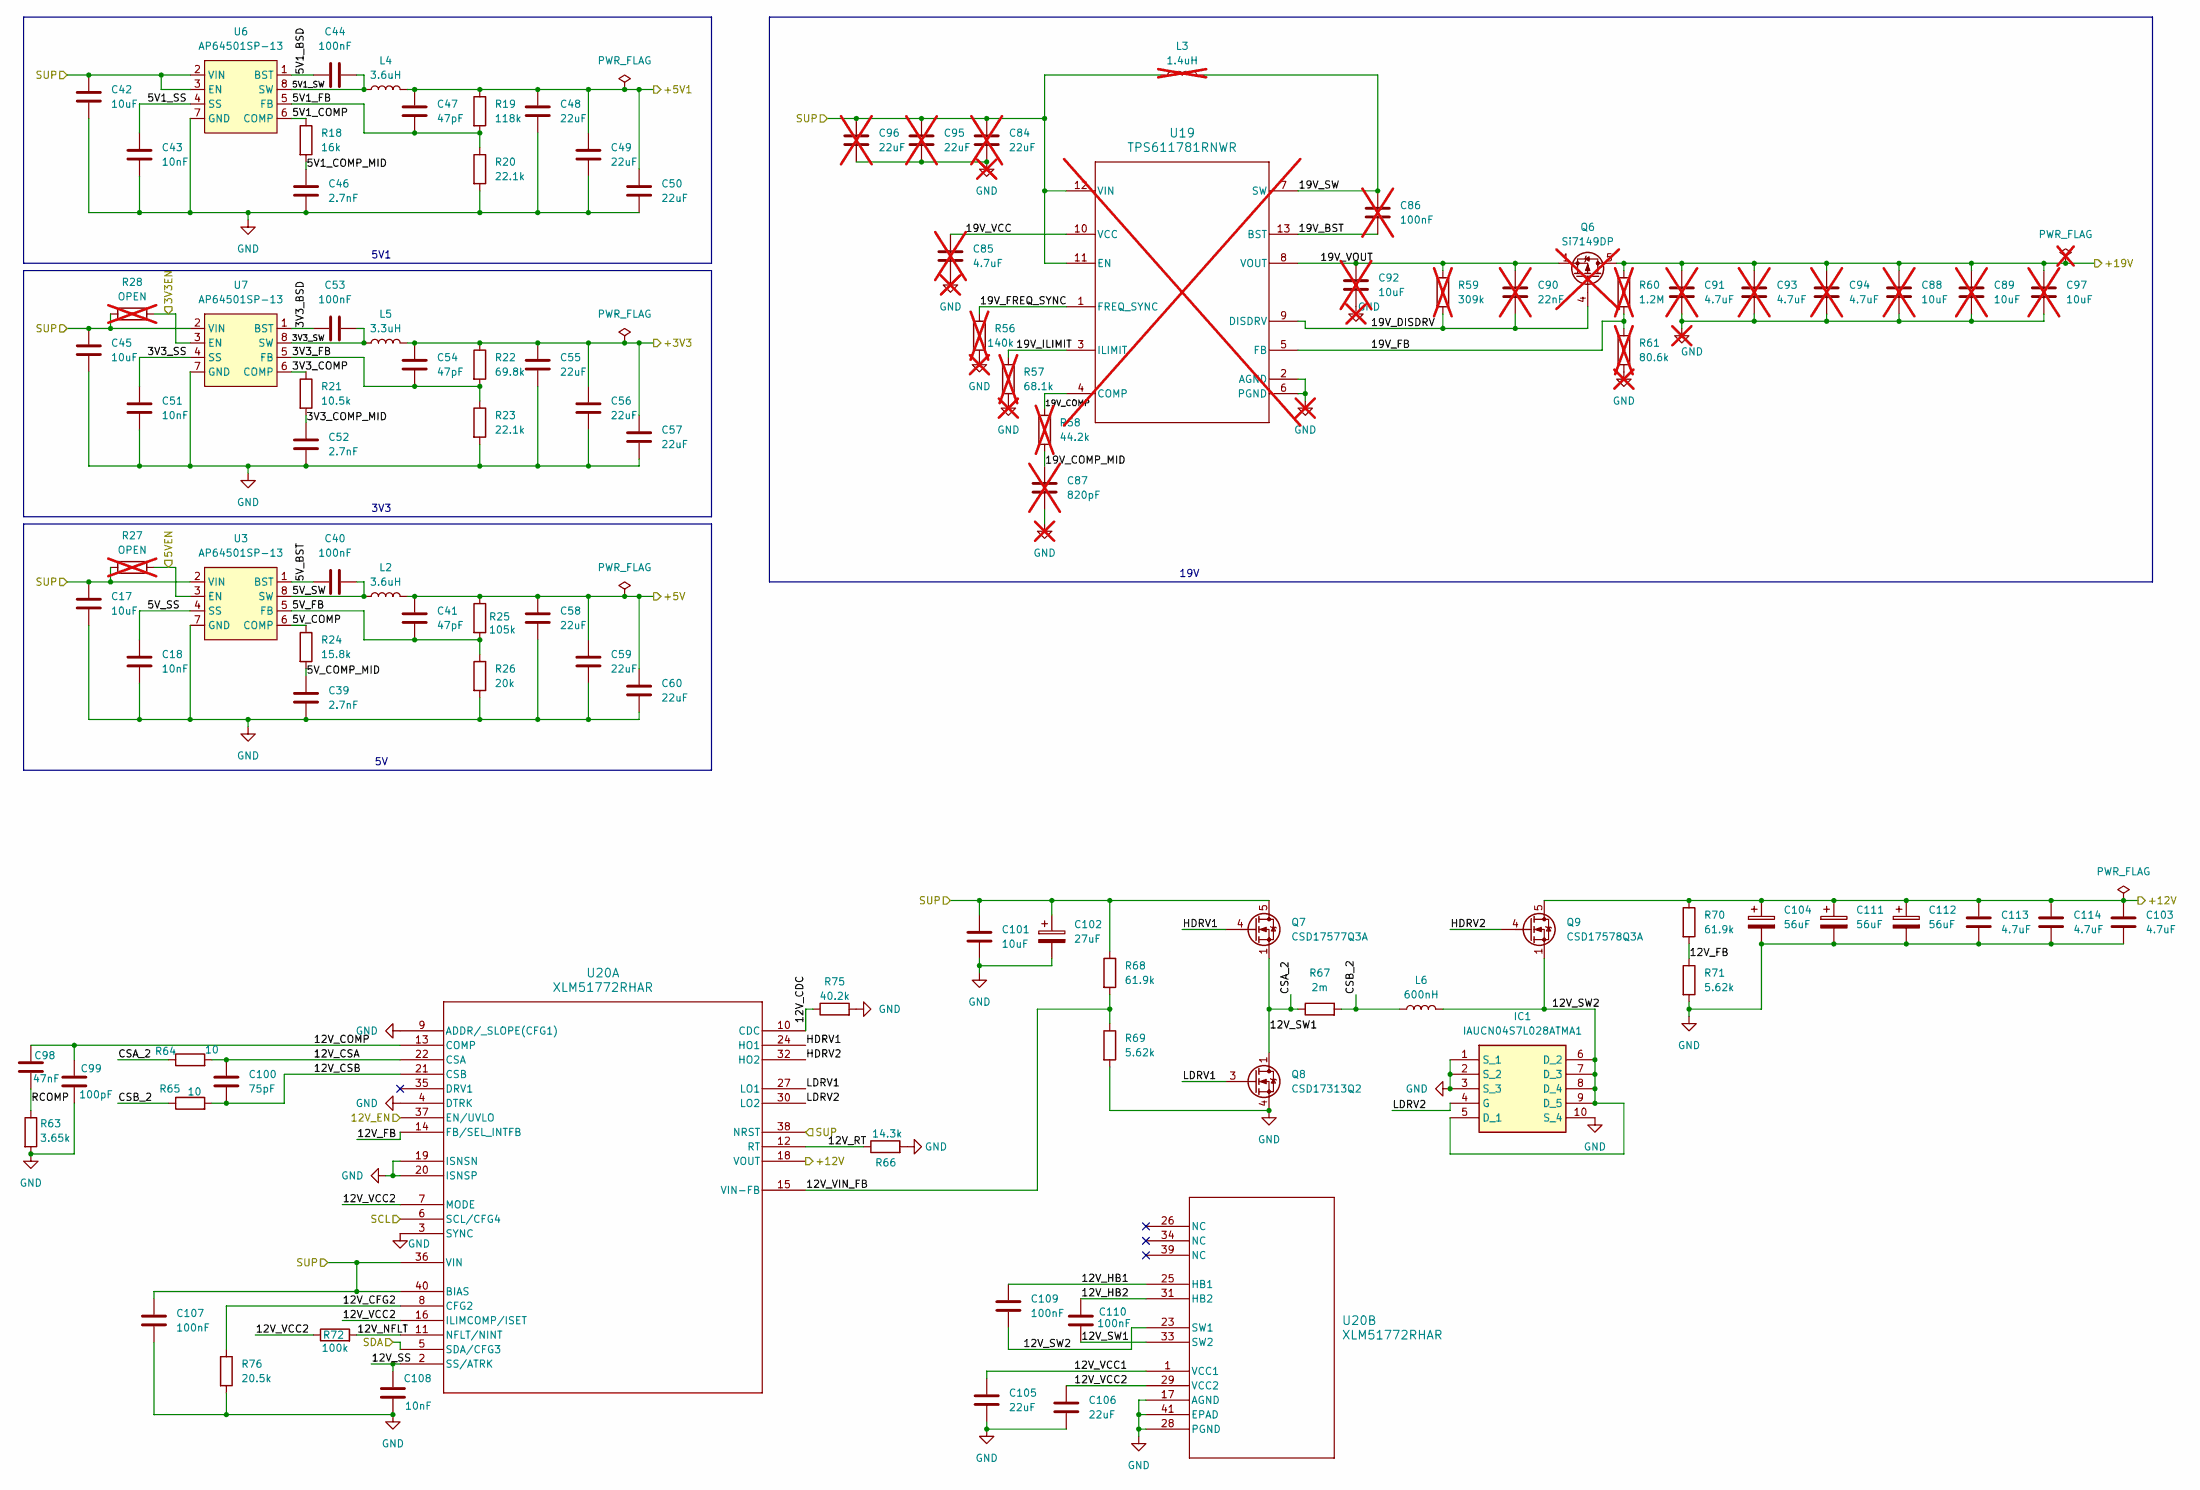
[picture p22: schematic regulators.kicad_sch]

Parts:
C17, C42, C45: 10uF; C_0402_1005Metric; LCSC C315248
C18, C43, C51, C108: 10nF; C_0402_1005Metric; LCSC C15195
C39, C46, C52: 2.7nF; C_0402_1005Metric; LCSC C84704
C40, C44, C53, C107, C109, C110: 100nF; C_0402_1005Metric; LCSC C307331
C41, C47, C54: 47pF; C_0402_1005Metric; LCSC C60137
C48, C49, C50, C55, C56, C57, C58, C59, C60: 22uF; C_0805_2012Metric; LCSC C602037
C84, C95, C96: 22uF; C_1210_3225Metric; LCSC C309062; not fitted
C85: 4.7uF; C_0402_1005Metric; LCSC C6119795; not fitted
C86: 100nF; C_0402_1005Metric; LCSC C307331; not fitted
C87: 820pF; C_0402_1005Metric; LCSC C107031; not fitted
C88, C89, C92, C97: 10uF; C_1210_3225Metric; LCSC C138687; not fitted
C90: 22nF; C_0805_2012Metric; LCSC C107147; not fitted
C91, C93, C94: 4.7uF; C_1206_3216Metric; LCSC C51205; not fitted
C98: 47nF; C_0402_1005Metric; LCSC C272875
C99: 100pF; C_0402_1005Metric; LCSC C106200
C100: 75pF; C_0402_1005Metric; LCSC C107010
C101: 10uF; C_0805_2012Metric; LCSC C2932476
C102: 27uF; CP_Elec_5x5.9; LCSC C347564
C103, C113, C114: 4.7uF; C_0805_2012Metric; LCSC C98192
C104, C111, C112: 56uF; CP_Elec_5x5.9; LCSC C2162042
C105, C106: 22uF; C_0603_1608Metric; LCSC C2762594
IC1: IAUCN04S7L028ATMA1; IAUC120N06S5N011ATMA1; Mouser Part Number 726-IAUCN04S7L028ATM
L2, L4: 3.6uH; NRS8040T3R6NJGJ; LCSC C223037
L3: 1.4uH; INDM7570X400N; LCSC C41239516; not fitted
L5: 3.3uH; CYA0630-3.3uH; LCSC C5189747
L6: 600nH; L_Coilcraft_XAL5030-XXX; LCSC C19191623
Q6: Si7149DP; PowerPAK_SO-8_Single; LCSC C553982; not fitted
Q7: CSD17577Q3A; VSON-8_3.3x3.3mm_P0.65mm_NexFET; LCSC C201632
Q8: CSD17313Q2; Texas_DQK; LCSC C2863837
Q9: CSD17578Q3A; VSON-8_3.3x3.3mm_P0.65mm_NexFET; LCSC C205986
R18: 16k; R_0402_1005Metric; LCSC C25759
R19: 118k; R_0402_1005Metric; LCSC C852490
R20, R23: 22.1k; R_0402_1005Metric; LCSC C163478
R21: 10.5k; R_0402_1005Metric; LCSC C5581335
R22: 69.8k; R_0402_1005Metric; LCSC C852893
R24: 15.8k; R_0402_1005Metric; LCSC C26956
R25: 105k; R_0402_1005Metric; LCSC C171671
R26: 20k; R_0402_1005Metric; LCSC C93942
R27, R28: OPEN; R_0603_1608Metric; not fitted
R56: 140k; R_0402_1005Metric; LCSC C114151; not fitted
R57: 68.1k; R_0402_1005Metric; LCSC C11537; not fitted
R58: 44.2k; R_0402_1005Metric; LCSC C25895; not fitted
R59: 309k; R_0402_1005Metric; LCSC C4180598; not fitted
R60: 1.2M; R_0603_1608Metric; LCSC C13315; not fitted
R61: 80.6k; R_0402_1005Metric; LCSC C25921; not fitted
R63: 3.65k; R_0402_1005Metric; LCSC C852768
R64, R65: 10; R_0603_1608Metric; LCSC C109318
R66: 14.3k; R_0402_1005Metric; LCSC C185465
R67: 2m; R_1206_3216Metric; LCSC C92124
R68, R70: 61.9k; R_0402_1005Metric; LCSC C852869
R69, R71: 5.62k; R_0402_1005Metric; LCSC C851068
R72: 100k; R_0402_1005Metric; LCSC C60491
R75: 40.2k; R_0402_1005Metric; LCSC C137983
R76: 20.5k; R_0402_1005Metric; LCSC C185445
U3, U6, U7: AP64501SP-13; SOIC-8-1EP_3.9x4.9mm_P1.27mm_EP2.29x3mm; LCSC C2071517
U19: TPS611781RNWR; RNW0013A; LCSC C2862009; not fitted
U20: XLM51772RHAR; VQFN40_RHA_TEX; LCSC C41383743

Connections:
+3V3: C54.1, C55.1, C56.1, C57.1, L5.2, R22.1; also elsewhere on the board
+5V: C41.1, C58.1, C59.1, C60.1, L2.2, R25.1; also elsewhere on the board
+5V1: C47.1, C48.1, C49.1, C50.1, L4.2, R19.1; also elsewhere on the board
+12V: C103.1, C104.1, C111.1, C112.1, C113.1, C114.1, Q9.5 (D), R70.1, U20.18 (VOUT); also elsewhere on the board
+19V: C88.1, C89.1, C91.1, C93.1, C94.1, C97.1, Q6.5 (D), R60.1; also elsewhere on the board
+BATT: C17.1, C42.1, C45.1, C84.1, C95.1, C96.1, C101.1, C102.1, C107.1, L3.1, Q7.5 (D), R27.1, R28.1, R68.1, U3.2 (VIN), U6.2 (VIN), U6.3 (EN), U7.2 (VIN), U19.11 (EN), U19.12 (VIN), U20.36 (VIN), U20.38 (NRST), U20.40 (BIAS); also elsewhere on the board
/GPIO16: R28.2, U7.3 (EN); also elsewhere on the board
/GPIO17: R27.2, U3.3 (EN); also elsewhere on the board
/I2C_SCL: U20.6 (SCL/CFG4); also elsewhere on the board
/I2C_SDA: U20.5 (SDA/CFG3); also elsewhere on the board
/PC5: U20.37 (EN/UVLO); also elsewhere on the board
/Regulators/3V3_BSD: C53.1, U7.1 (BST)
/Regulators/3V3_COMP: R21.1, U7.6 (COMP)
/Regulators/3V3_COMP_MID: C52.1, R21.2
/Regulators/3V3_FB: C54.2, R22.2, R23.1, U7.5 (FB)
/Regulators/3V3_SS: C51.1, U7.4 (SS)
/Regulators/3V3_SW: C53.2, L5.1, U7.8 (SW)
/Regulators/5V1_BSD: C44.1, U6.1 (BST)
/Regulators/5V1_COMP: R18.1, U6.6 (COMP)
/Regulators/5V1_COMP_MID: C46.1, R18.2
/Regulators/5V1_FB: C47.2, R19.2, R20.1, U6.5 (FB)
/Regulators/5V1_SS: C43.1, U6.4 (SS)
/Regulators/5V1_SW: C44.2, L4.1, U6.8 (SW)
/Regulators/5V_BST: C40.1, U3.1 (BST)
/Regulators/5V_COMP: R24.1, U3.6 (COMP)
/Regulators/5V_COMP_MID: C39.1, R24.2
/Regulators/5V_FB: C41.2, R25.2, R26.1, U3.5 (FB)
/Regulators/5V_SS: C18.1, U3.4 (SS)
/Regulators/5V_SW: C40.2, L2.1, U3.8 (SW)
/Regulators/12V_CDC: R75.1, U20.10 (CDC)
/Regulators/12V_CFG2: R76.1, U20.8 (CFG2)
/Regulators/12V_COMP: C98.1, C99.1, U20.13 (COMP)
/Regulators/12V_CSA: C100.1, R64.2, U20.22 (CSA)
/Regulators/12V_CSB: C100.2, R65.2, U20.21 (CSB)
/Regulators/12V_FB: R70.2, R71.1, U20.14 (FB/SEL_INTFB)
/Regulators/12V_HB1: C109.1, U20.25 (HB1)
/Regulators/12V_HB2: C110.1, U20.31 (HB2)
/Regulators/12V_NFLT: R72.2, U20.11 (NFLT/NINT)
/Regulators/12V_RT: R66.1, U20.12 (RT)
/Regulators/12V_SS: C108.1, U20.2 (SS/ATRK)
/Regulators/12V_SW1: C110.2, Q7.1 (S), Q7.2 (S), Q7.3 (S), Q8.1 (D), Q8.2 (D), Q8.5 (D), Q8.6 (D), Q8.8 (D), R64.1, R67.1, U20.33 (SW2)
/Regulators/12V_SW2: C109.2, IC1.5 (D_1), IC1.6 (D_2), IC1.7 (D_3), IC1.8 (D_4), IC1.9 (D_5), L6.2, Q9.1 (S), Q9.2 (S), Q9.3 (S), U20.23 (SW1)
/Regulators/12V_VCC1: C105.1, U20.1 (VCC1)
/Regulators/12V_VCC2: C106.1, R72.1, U20.7 (MODE), U20.16 (ILIMCOMP/ISET), U20.29 (VCC2)
/Regulators/12V_VIN_FB: R68.2, R69.1, U20.15 (VIN-FB)
/Regulators/19V_BST: C86.2, U19.13 (BST)
/Regulators/19V_COMP: R58.1, U19.4 (COMP)
/Regulators/19V_COMP_MID: C87.1, R58.2
/Regulators/19V_DISDRV: C90.2, Q6.4 (G), R59.2, U19.9 (DISDRV)
/Regulators/19V_FB: R60.2, R61.1, U19.5 (FB)
/Regulators/19V_FREQ_SYNC: R56.1, U19.1 (FREQ_SYNC)
/Regulators/19V_ILIMIT: R57.1, U19.3 (ILIMIT)
/Regulators/19V_SW: C86.1, L3.2, U19.7 (SW)
/Regulators/19V_VCC: C85.1, U19.10 (VCC)
/Regulators/19V_VOUT: C90.1, C92.1, Q6.1 (S), Q6.2 (S), Q6.3 (S), R59.1, U19.8 (VOUT)
/Regulators/CSB_2: L6.1, R65.1, R67.2
/Regulators/HDRV1: Q7.4 (G), U20.24 (HO1)
/Regulators/HDRV2: Q9.4 (G), U20.32 (HO2)
/Regulators/LDRV1: Q8.3 (G), U20.27 (LO1)
/Regulators/LDRV2: IC1.4 (G), U20.30 (LO2)
/Regulators/RCOMP: C98.2, R63.1
GND: C17.2, C18.2, C39.2, C42.2, C43.2, C45.2, C46.2, C48.2, C49.2, C50.2, C51.2, C52.2, C55.2, C56.2, C57.2, C58.2, C59.2, C60.2, C84.2, C85.2, C87.2, C88.2, C89.2, C91.2, C92.2, C93.2, C94.2, C95.2, C96.2, C97.2, C99.2, C101.2, C102.2, C103.2, C104.2, C105.2, C106.2, C107.2, C108.2, C111.2, C112.2, C113.2, C114.2, IC1.1 (S_1), IC1.2 (S_2), IC1.3 (S_3), IC1.10 (S_4), Q8.4 (S), Q8.7 (S), R20.2, R23.2, R26.2, R56.2, R57.2, R61.2, R63.2, R66.2, R69.2, R71.2, R75.2, R76.2, U3.7 (GND), U3.9 (PAD), U6.7 (GND), U6.9 (PAD), U7.7 (GND), U7.9 (PAD), U19.2 (AGND), U19.6 (PGND), U20.3 (SYNC), U20.4 (DTRK), U20.9 (ADDR/_SLOPE(CFG1)), U20.17 (AGND), U20.19 (ISNSN), U20.20 (ISNSP), U20.28 (PGND), U20.41 (EPAD); also elsewhere on the board

Notes on the sheet:
19V
3V3
5V1
