Wet-Lettuce-Robocup/robot_pcb/robot_pcb.kicad_pcb

## KiCad design robot_pcb.kicad_pcb (continued)

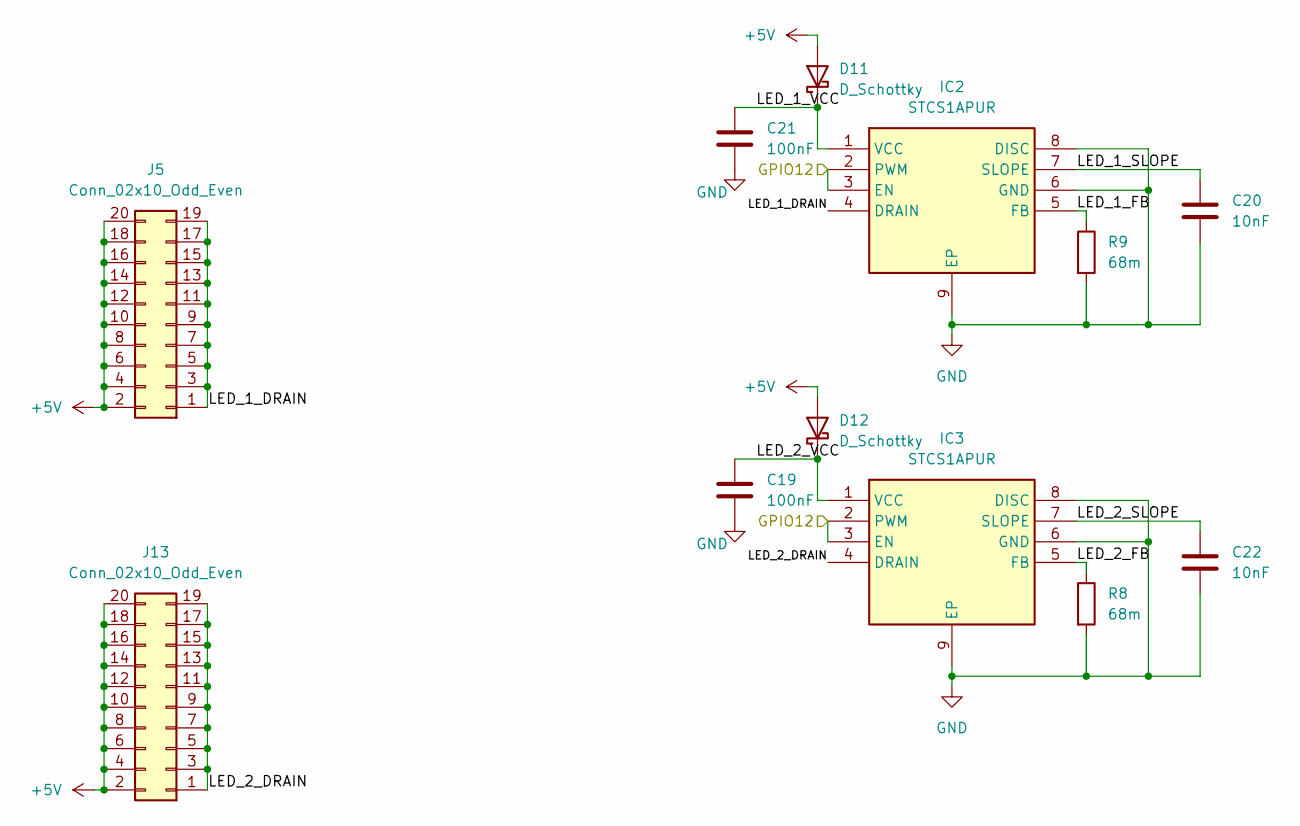
[picture p23: schematic frontleds.kicad_sch]

Parts:
C19, C21: 100nF; C_0402_1005Metric; LCSC C307331
C20, C22: 10nF; C_0402_1005Metric; LCSC C15195
D11, D12: D_Schottky; D_SOD-123; LCSC C83528
IC2, IC3: STCS1APUR; SON50P300X300X100-9N-D; Mouser Part Number 511-STCS1APUR
J5, J13: Conn_02x10_Odd_Even; Samtec_HSEC8-110-01-X-DV-A_2x10_P0.8mm_Socket_AlignmentPins; LCSC C4572809
R8, R9: 68m; R_0402_1005Metric; LCSC C728416

Connections:
+5V: D11.2 (A), D12.2 (A), J5.2, J5.4, J5.6, J5.8, J5.10, J5.12, J5.14, J5.16, J5.18, J5.20, J13.2, J13.4, J13.6, J13.8, J13.10, J13.12, J13.14, J13.16, J13.18, J13.20; also elsewhere on the board
/Front LEDs/GPIO12: IC2.2 (PWM), IC2.3 (EN), IC3.2 (PWM), IC3.3 (EN); also elsewhere on the board
/Front LEDs/LED_1_DRAIN: IC2.4 (DRAIN), J5.1, J5.3, J5.5, J5.7, J5.9, J5.11, J5.13, J5.15, J5.17, J5.19
/Front LEDs/LED_1_FB: IC2.5 (FB), R9.1
/Front LEDs/LED_1_SLOPE: C20.2, IC2.7 (SLOPE)
/Front LEDs/LED_1_VCC: C21.1, D11.1 (K), IC2.1 (VCC)
/Front LEDs/LED_2_DRAIN: IC3.4 (DRAIN), J13.1, J13.3, J13.5, J13.7, J13.9, J13.11, J13.13, J13.15, J13.17, J13.19
/Front LEDs/LED_2_FB: IC3.5 (FB), R8.1
/Front LEDs/LED_2_SLOPE: C22.1, IC3.7 (SLOPE)
/Front LEDs/LED_2_VCC: C19.1, D12.1 (K), IC3.1 (VCC)
GND: C19.2, C20.1, C21.2, C22.2, IC2.6 (GND), IC2.8 (DISC), IC2.9 (EP), IC3.6 (GND), IC3.8 (DISC), IC3.9 (EP), R8.2, R9.2; also elsewhere on the board

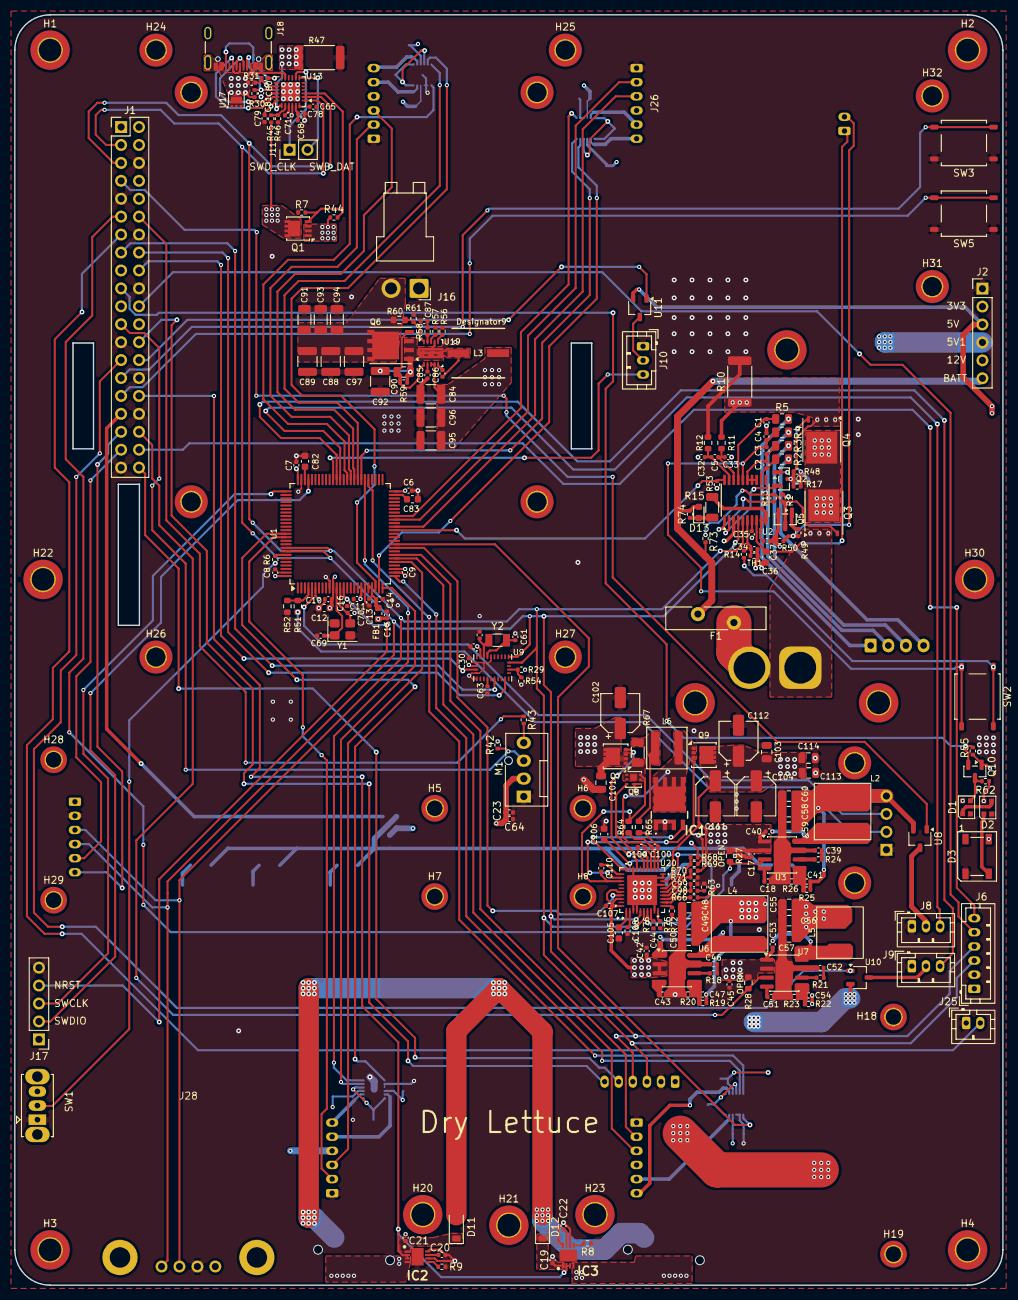
[picture p24: board robot_pcb.kicad_pcb from above]

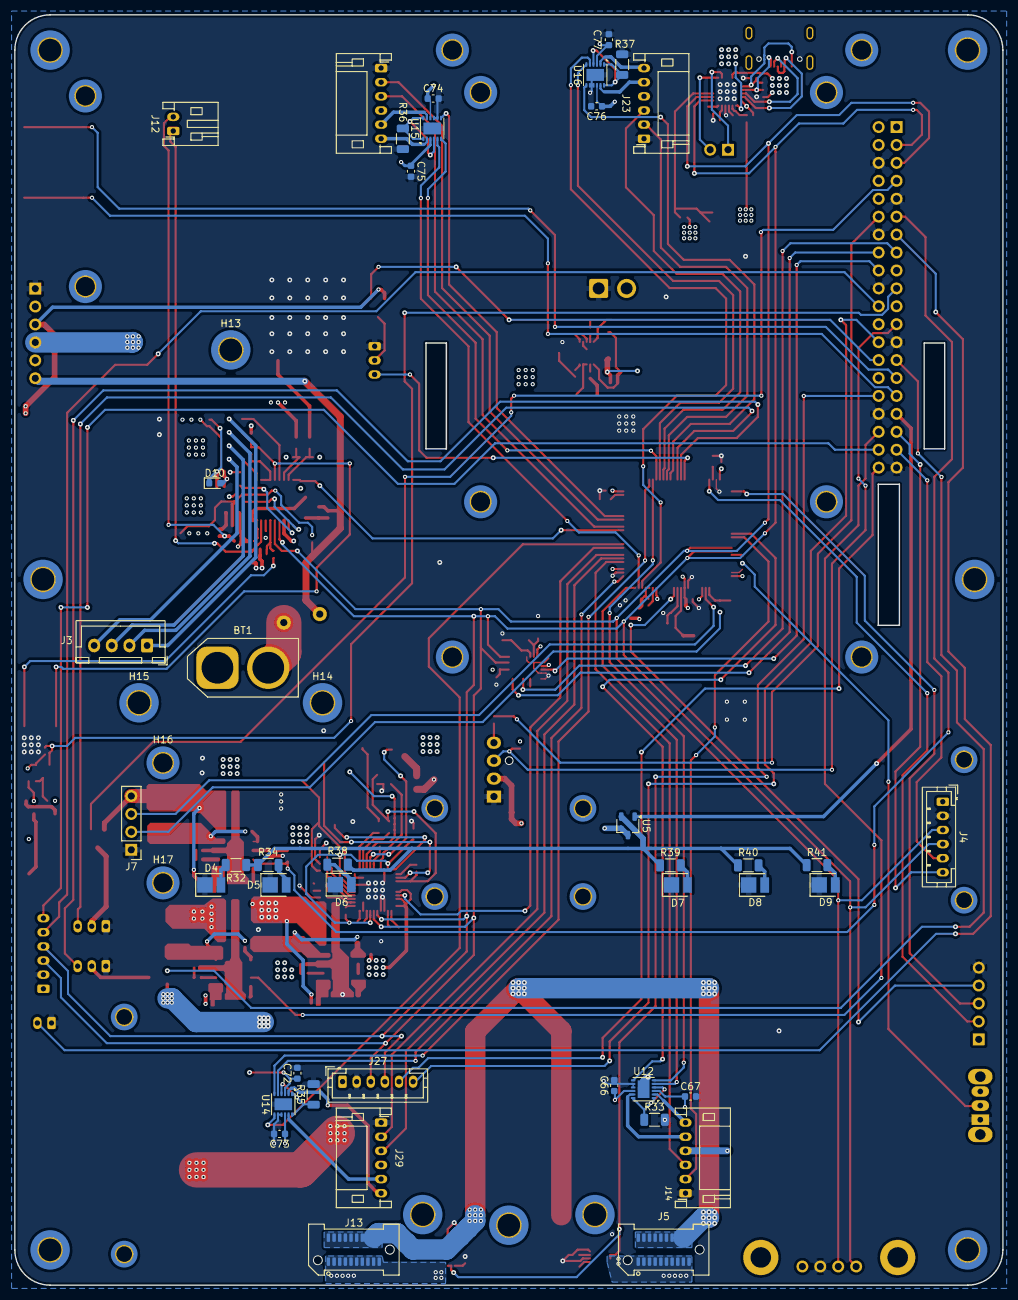
[picture p25: board robot_pcb.kicad_pcb from below]

Board: 4 copper layers, 140.0 x 180.0 mm, 297 parts (47 on the bottom side), 195 nets.
