Wet-Lettuce-Robocup/robot_pcb/(commit log)

2026-01-19 added empty sheets for each voltage regulator
    [regulator_12v.kicad_sch, regulator_3v3.kicad_sch, regulator_5v.kicad_sch, robot_pcb.kicad_sch]
2026-01-19 add components
    [robot_pcb.kicad_sch]
2026-01-20 added custom symbols for motor connectors
    [robot_pcb.kicad_sch]
2026-01-20 updated motor connector reference from u to j to match the fact that it is a connector
    [robot_pcb.kicad_sch]
2026-01-20 Add README for Wet Lettuce Robot PCB project
2026-01-20 added power circuitry to stm32
    [robot_pcb.kicad_sch]
2026-01-20 added some pin definitions for stm32
    [robot_pcb.kicad_sch]
2026-01-21 3v3 done
    [robot_pcb.kicad_sch]
2026-01-21 added 12v circuit, no values yet
    [regulator_12v.kicad_sch, robot_pcb.kicad_sch]
2026-01-21 added values
    [regulator_12v.kicad_sch, robot_pcb.kicad_sch]
2026-01-21 connected sync and sps to vcc
    [regulator_12v.kicad_sch, robot_pcb.kicad_sch]
2026-01-21 bms nearly finished
    [battery.kicad_sch, regulator_12v.kicad_sch, robot_pcb.kicad_sch]
2026-01-21 added polyfuse for added safety
    [battery.kicad_sch]
2026-01-21 added pull down resistor to chg pin as it is not used
    [battery.kicad_sch]
2026-01-21 bring back 3v3
    [battery.kicad_sch, regulator_12v.kicad_sch, robot_pcb.kicad_sch]
2026-01-21 added separate ground for battery protection circuit
    [battery.kicad_sch]
2026-01-21 5v1 started
    [regulator_5v1.kicad_sch, robot_pcb.kicad_sch]
2026-01-21 sorry can ignore if u want
    [battery.kicad_sch, regulator_5v1.kicad_sch]
2026-01-21 re-added gnd1 to bms
    [battery.kicad_sch]
2026-01-22 added labels to stm32 outputs
    [battery.kicad_sch, robot_pcb.kicad_sch]
2026-01-22 created symbol and footprint for motor driver, and connected to stm32
    [robot_pcb.kicad_sch]
2026-01-22 all one component?
    [regulator_5v1.kicad_sch, robot_pcb.kicad_sch]
2026-01-22 restored main file
    [robot_pcb.kicad_sch]
2026-01-22 added debug output
    [robot_pcb.kicad_sch]
2026-01-22 added usb c port
    [robot_pcb.kicad_sch]
2026-01-22 remove 12V
    [regulator_5v1.kicad_sch, robot_pcb.kicad_sch]
2026-01-22 remove other
    [robot_pcb.kicad_sch]
2026-01-22 regulators in one file
    [regulators.kicad_sch, robot_pcb.kicad_sch]
2026-01-22 fix leds
    [robot_pcb.kicad_sch]
2026-01-23 cleaned up some sheet pins
    [regulators.kicad_sch, robot_pcb.kicad_sch]
2026-01-24 added footprints to all components in 12v regulator
    [regulator_12v.kicad_sch, robot_pcb.kicad_sch]
2026-01-24 probably didn't need that many capacitors on the 12v output
    [regulator_12v.kicad_sch, regulators.kicad_sch, robot_pcb.kicad_sch]
2026-01-24 added more labels
    [regulator_12v.kicad_sch, robot_pcb.kicad_sch]
2026-01-24 part numebrs
    [battery.kicad_sch, regulator_12v.kicad_sch, regulators.kicad_sch, robot_pcb.kicad_sch]
2026-01-25 added pwm to servos
    [robot_pcb.kicad_sch]
2026-01-25 added some footprints
    [battery.kicad_sch]
2026-01-25 fixed lipo symbol
    [battery.kicad_sch]
2026-01-25 fixed bad ground placement
    [battery.kicad_sch, robot_pcb.kicad_pcb]
2026-01-25 Added BNO086
    [robot_pcb.kicad_pcb, robot_pcb.kicad_sch]
2026-01-25 small changes
    [robot_pcb.kicad_sch]
2026-01-27 added some more footprints
    [battery.kicad_sch, robot_pcb.kicad_sch]
2026-01-29 conductive test claw
    [robot_pcb.kicad_sch]
2026-02-01 regulators layout
    [regulators.kicad_sch, robot_pcb.kicad_pcb]
2026-02-01 update regulators layout
    [regulators.kicad_sch, robot_pcb.kicad_pcb]
2026-02-02 fixed whatever was going on with i2c
    [battery.kicad_sch, robot_pcb.kicad_sch]
2026-02-02 added some more stuff to pcb
    [robot_pcb.kicad_pcb]
2026-02-02 working on stm32
    [robot_pcb.kicad_pcb]
2026-02-02 added footprints for almost everything
    [battery.kicad_sch, robot_pcb.kicad_pcb, robot_pcb.kicad_sch]
2026-02-02 added crystal oscillator to pcb
    [robot_pcb.kicad_pcb]
2026-02-02 mostly finished stm
    [regulators.kicad_sch, robot_pcb.kicad_pcb, robot_pcb.kicad_sch]
2026-02-02 added schematics and footprints to project
    [battery.kicad_sch, regulator_12v.kicad_sch, robot_pcb.kicad_pcb, robot_pcb.kicad_sch]
2026-02-02 working on bms layout
    [battery.kicad_sch, robot_pcb.kicad_pcb]
2026-02-02 update inductor footprint to drylettuce library
    [battery.kicad_sch, regulators.kicad_sch]
2026-02-02 started routing one regulator
    [robot_pcb.kicad_pcb]
2026-02-02 working on bms layout v2
    [battery.kicad_sch, robot_pcb.kicad_pcb]
2026-02-02 finised layout for bms (no traces yet)
    [robot_pcb.kicad_pcb]
2026-02-02 this is probably better tbh
    [robot_pcb.kicad_pcb]
2026-02-02 12v regulator layout
    [robot_pcb.kicad_pcb]
2026-02-02 finished bno086 layout
    [robot_pcb.kicad_pcb]
2026-02-02 added some tracks
    [battery.kicad_sch, robot_pcb.kicad_pcb]
2026-02-02 fat traces
    [robot_pcb.kicad_pcb]
2026-02-02 12v wired up
    [robot_pcb.kicad_pcb]
2026-02-02 made 12v inductor traces thicker
    [robot_pcb.kicad_pcb]
2026-02-02 removed random bit of copper
    [robot_pcb.kicad_pcb]
2026-02-02 flipped battery connectors
    [robot_pcb.kicad_pcb]
2026-02-03 added board outline
    [robot_pcb.kicad_pcb]
2026-02-03 moved some stuff to roughly where it will be
    [robot_pcb.kicad_pcb]
2026-02-03 idrk what i changed tbh but probably not anything important
    [battery.kicad_sch, robot_pcb.kicad_pcb]
2026-02-04 add new board dxf
    [robot_pcb.kicad_pcb, robot_pcb.kicad_sch]
2026-02-04 update pcb and schematic
    [robot_pcb.kicad_pcb, robot_pcb.kicad_sch]
2026-02-04 changed motor driver outline from margin to courtyard layer
    [robot_pcb.kicad_pcb]
2026-02-04 oled fix
    [robot_pcb.kicad_pcb, robot_pcb.kicad_sch]
2026-02-04 moving thjings around
    [robot_pcb.kicad_pcb]
2026-02-04 add holes
    [robot_pcb.kicad_pcb, robot_pcb.kicad_sch]
2026-02-04 Add multiple mounting hole footprints
    [robot_pcb.kicad_pcb, robot_pcb.kicad_sch]
2026-02-04 updated drawing from fusion
    [robot_pcb.kicad_pcb]
2026-02-05 more moving
    [robot_pcb.kicad_pcb]
2026-02-06 need to do motor driver
    [MotorDriver.kicad_sch, robot_pcb.kicad_sch]
2026-02-06 yeah idk what im doing someone fix
    [robot_pcb.kicad_pcb, robot_pcb.kicad_sch]
2026-02-06 learning kicad by making some holes
    [robot_pcb.kicad_pcb, robot_pcb.kicad_sch]
2026-02-07 added title to pcb schematic
    [robot_pcb.kicad_sch]
2026-02-07 Add PCB Edge.Cuts outline and group
    Updated robot_pcb.kicad_pcb to add multiple Edge.Cuts primitives (gr_line and gr_arc) that define the PCB perimeter and related cut features, and added a group element that aggregates their UUIDs. These changes define the board outline for fabrication and organize the newly added edge objects in the file.
    copilot commit description is awesome considering its looking at only text
    [robot_pcb.kicad_pcb]
2026-02-08 add driver symbol real
2026-02-08 motor drivers done
    [MotorDriver.kicad_sch, robot_pcb.kicad_sch]
2026-02-09 added motor drivers and leds to pcb
    [battery.kicad_sch, down_leds.kicad_sch, robot_pcb.kicad_pcb, robot_pcb.kicad_sch]
2026-02-09 moved motor drivers around
    [robot_pcb.kicad_pcb, robot_pcb.kicad_sch]
2026-02-09 add inductor footprint
    [regulators.kicad_sch, robot_pcb.kicad_pcb]
2026-02-09 routing voltage reguulators
    [robot_pcb.kicad_pcb]
2026-02-09 merged all voltage bypasses into one
    [robot_pcb.kicad_sch]
2026-02-09 updated pcb
    [robot_pcb.kicad_pcb]
2026-02-10 wired up some motor drivers, idk if this is right tho
    [robot_pcb.kicad_pcb]
2026-02-10 changed switch footprint for stm32 boot0
    [robot_pcb.kicad_pcb, robot_pcb.kicad_sch]
2026-02-10 finished wiring motor drivers and moved boot button
    [down_leds.kicad_sch, robot_pcb.kicad_pcb]
2026-02-10 attempted to wire some stuff, its a bit of a mess tho feel free to delete
    [robot_pcb.kicad_pcb]
2026-02-11 route last regulator and changed ultrasonic connector
    [robot_pcb.kicad_pcb, robot_pcb.kicad_sch]
2026-02-11 moved ultrasonic
    [robot_pcb.kicad_pcb, robot_pcb.kicad_sch]
2026-02-11 add tofs
    [robot_pcb.kicad_sch]
2026-02-11 moved a single resistor
    [robot_pcb.kicad_pcb]
2026-02-12 something changed maybe
    [robot_pcb.kicad_pcb]
2026-02-12 connected front motor drivers better
    [robot_pcb.kicad_pcb, robot_pcb.kicad_sch]
2026-02-12 wired motor drivers more
    [robot_pcb.kicad_pcb]
2026-02-12 made 4 layers for ground and power planes
    [robot_pcb.kicad_pcb]
2026-02-13 added a power plane thing for gnd1
    [robot_pcb.kicad_pcb]
2026-02-13 more routing
    [robot_pcb.kicad_pcb]
2026-02-13 wired everything else except for new tof sensors cos we might need a multiplexer idk
    [robot_pcb.kicad_pcb]
2026-02-13 removed redundant vias
    [robot_pcb.kicad_pcb]
2026-02-13 bro why did it do that i thought i fixed that anyway its fixed now
    [robot_pcb.kicad_pcb]
2026-02-13 Shifted whole pcb + connected tofs
    Hopefully pcb is aligned to the grid now. Somebody please check my wiring bc it's probably cooked but I gave it a go anyway.
    [robot_pcb.kicad_pcb]
2026-02-13 changed usb connector footprint
    [robot_pcb.kicad_pcb, robot_pcb.kicad_sch]
2026-02-13 jetson holes
    [robot_pcb.kicad_pcb, robot_pcb.kicad_sch]
2026-02-13 Updated UserDrawings to add tof position and mounting holes
    Had to reroute some traces, should be fine
    [robot_pcb.kicad_pcb, robot_pcb.kicad_sch]
2026-02-13 cleaning up routing
    [robot_pcb.kicad_pcb]
2026-02-14 Added connector for PWM fan
    Tachometer -> PI GPIO11
    PWM -> PI PWM1
    [robot_pcb.kicad_pcb, robot_pcb.kicad_sch]
2026-02-14 12v Routing
    [robot_pcb.kicad_pcb]
2026-02-14 power plane routing
    [robot_pcb.kicad_pcb]
2026-02-14 need to update servo mosfet
    [robot_pcb.kicad_sch]
2026-02-14 probably fixed some drc violations
    also changed middle layers settings to be power instead of signal, i think thats useful?
    [robot_pcb.kicad_pcb]
2026-02-14 made gnd1 plane have priority over gnd
    [robot_pcb.kicad_pcb]
2026-02-14 error cleanup
    [robot_pcb.kicad_pcb, robot_pcb.kicad_sch]
2026-02-14 Added better power management for fan and adjusted tofs
    Probably broke something tbh. Added some resistors and a capacitor, changed tofs to actually be on the back layer lmao
    [robot_pcb.kicad_pcb, robot_pcb.kicad_sch]
2026-02-14 moved front motor drivers to bottom layer
    [robot_pcb.kicad_pcb]
2026-02-14 moved back motor drivers to bottom layer
    [robot_pcb.kicad_pcb]
2026-02-15 connected cc pins on usb c connector to 5.1v instead of 5v
    [robot_pcb.kicad_pcb, robot_pcb.kicad_sch]
2026-02-15 updated all footprints cos kicad was complaining hopefully that didn't break anything
    [robot_pcb.kicad_pcb]
2026-02-15 replaced some sketch connections in the 12v regulator with filled zones
    [robot_pcb.kicad_pcb]
2026-02-15 This footprint must have been autogenerated or something because there is NO WAY a sane human made it anyway fixed some stuff
    [robot_pcb.kicad_pcb]
2026-02-15 update mdriver pad
    [robot_pcb.kicad_pcb, robot_pcb.kicad_sch]
2026-02-15 fixed some routing
    [robot_pcb.kicad_pcb]
2026-02-15 fixed some errors an stuff
    [robot_pcb.kicad_pcb]
2026-02-16 i think its fine?
    @will-da-pro help
    [MotorDriver.kicad_sch, battery.kicad_sch, down_leds.kicad_sch, regulator_12v.kicad_sch, regulator_3v3.kicad_sch, regulator_5v.kicad_sch, regulator_5v1.kicad_sch, regulators.kicad_sch]
2026-02-16 pd controller started
    [pd_ic.kicad_sch, robot_pcb.kicad_sch]
2026-02-16 probably works
    [pd_ic.kicad_sch, robot_pcb.kicad_pcb]
2026-02-16 work on pd ic
    [pd_ic.kicad_sch]
2026-02-16 idk it showed question marks again
    [pd_ic.kicad_sch]
2026-02-16 MOVED MOUNTING HOLES, updated edge cuts + drawings
    should have split into 2 changes but anyway
    [robot_pcb.kicad_pcb]
2026-02-16 mounting holes for handle + updated pcb from sch
    [pd_ic.kicad_sch, robot_pcb.kicad_pcb, robot_pcb.kicad_sch]
2026-02-17 added usb c thing to pcb
    [pd_ic.kicad_sch, robot_pcb.kicad_pcb, robot_pcb.kicad_sch]
2026-02-17 actually connected the vias this time
    [robot_pcb.kicad_pcb]
2026-02-17 hopefully those can be left as nc unless google ai is gaslighting me
    [pd_ic.kicad_sch, robot_pcb.kicad_pcb]
2026-02-17 fixed super cooked regulators
    [regulators.kicad_sch, robot_pcb.kicad_pcb, robot_pcb.kicad_sch]
2026-02-17 connected regulators to +batt
    [robot_pcb.kicad_pcb]
2026-02-18 fixed all unconnected items
    [robot_pcb.kicad_pcb]
2026-02-18 added more vias for power lines
    [robot_pcb.kicad_pcb]
2026-02-18 a 90º turn has been eliminated
    [robot_pcb.kicad_pcb]
2026-02-19 fixed usb c pd ic schematic
    [pd_ic.kicad_sch]
2026-02-19 added tvs diode to schematic of usb c port
    [pd_ic.kicad_sch]
2026-02-19 added new stuff to pcb
    [pd_ic.kicad_sch, robot_pcb.kicad_pcb]
2026-02-19 changed some values for battery protection circuit
    [battery.kicad_sch]
2026-02-19 changed some more values
    [battery.kicad_sch, robot_pcb.kicad_pcb]
2026-02-20 replaced mosfet for main power supply cos it was too overpowered
    [battery.kicad_sch, robot_pcb.kicad_pcb]
2026-02-20 added chg protection fet to BQ76920PW
    [battery.kicad_sch]
2026-02-20 moved stuff
    [robot_pcb.kicad_pcb]
2026-02-20 kinda cooked kill switch but i think it should work
    [battery.kicad_sch, pd_ic.kicad_sch]
2026-02-20 if it's cooked but it works it's still cooked but at least it works
    [battery.kicad_sch, robot_pcb.kicad_pcb]
2026-02-20 made kill switch actually work
    [battery.kicad_sch]
2026-02-20 aligned switch with mounting holes
    [robot_pcb.kicad_pcb]
2026-02-20 updated mounting hole footprints
    [robot_pcb.kicad_pcb, robot_pcb.kicad_sch]
2026-02-20 something changed
    [battery.kicad_sch, robot_pcb.kicad_pcb]
2026-02-20 moved one of the encoder traces cos it looks cleaner
    [robot_pcb.kicad_pcb]
2026-02-20 fixed silkscreen for usb controller and stm32
    [robot_pcb.kicad_pcb]
2026-02-20 fixed silkscreen for voltage regulators
    [robot_pcb.kicad_pcb]
2026-02-20 fixed all possible silkscreen violations
    [robot_pcb.kicad_pcb]
2026-02-20 small changes to some label positions
    [robot_pcb.kicad_pcb]
2026-02-20 small change
    [robot_pcb.kicad_pcb]
2026-02-20 all drc errors gone, changed footprints
    some footprints were cooked so i just removed or moved stuff on the silkscreen layer of each footprint
    [robot_pcb.kicad_pcb]
2026-02-21 fixed some problems with stm32 capacitors
    [robot_pcb.kicad_pcb, robot_pcb.kicad_sch]
2026-02-21 connected side ultrasonic to stm32
    [robot_pcb.kicad_pcb, robot_pcb.kicad_sch]
2026-02-21 added resistor voltage divider for ultrasonic
    [robot_pcb.kicad_pcb, robot_pcb.kicad_sch]
2026-02-21 connected some unconnected pins
    [battery.kicad_sch, robot_pcb.kicad_pcb, robot_pcb.kicad_sch]
2026-02-21 connected fault pins on motor drivers to stm32
    [robot_pcb.kicad_pcb, robot_pcb.kicad_sch]
2026-02-21 unfinished changes part 1
    [robot_pcb.kicad_pcb]
2026-02-21 moved kill-switch further back
    [robot_pcb.kicad_pcb]
2026-02-21 add frontleds
    [battery.kicad_sch, frontleds.kicad_sch, robot_pcb.kicad_pcb, robot_pcb.kicad_sch]
2026-02-22 finished adding front leds
    probably works idk
    [frontleds.kicad_sch, robot_pcb.kicad_pcb]
2026-02-23 send help
    [frontleds.kicad_sch, robot_pcb.kicad_pcb, robot_pcb.kicad_sch]
2026-02-24 added symbol and footprint for 19v regulator
2026-02-24 stuf w button
    [robot_pcb.kicad_pcb, robot_pcb.kicad_sch]
2026-02-24 more stuff with switches n things
    [battery.kicad_sch, frontleds.kicad_sch, robot_pcb.kicad_pcb]
2026-02-26 added schematic for 19v regulator (no footprints or values yet)
    [RNW0013A.stp, frontleds.kicad_sch, regulators.kicad_sch]
2026-02-26 added values to 19v reg components
    [regulators.kicad_sch]
2026-02-26 started adding 19v reg to pcb (unfinished)
    [MLC7540-142MEB.stp, regulators.kicad_sch, robot_pcb.kicad_pcb, robot_pcb.kicad_sch]
2026-02-26 finished routing for 19v regulator
    [regulators.kicad_sch, robot_pcb.kicad_pcb]
2026-02-26 horizontal jst
    [robot_pcb.kicad_pcb, robot_pcb.kicad_sch]
2026-02-26 moved traces apart
    [robot_pcb.kicad_pcb]
2026-02-26 moved odometry over and increased distance between some traces
    [robot_pcb.kicad_pcb]
2026-02-26 wired front leds
    [robot_pcb.kicad_pcb]
2026-02-26 fixed ALL drc errors and warnings
    [robot_pcb.kicad_pcb, robot_pcb.kicad_sch]
2026-02-26 added labels to everything
    [battery.kicad_sch, down_leds.kicad_sch, frontleds.kicad_sch, pd_ic.kicad_sch, regulator_12v.kicad_sch, regulators.kicad_sch, robot_pcb.kicad_pcb, robot_pcb.kicad_sch]
2026-02-26 border around 19v reg
    [regulators.kicad_sch]
2026-02-27 put in some vias so it looks a bit better with gnd plane
    [robot_pcb.kicad_pcb]
2026-02-27 fixed a drc violation
    [robot_pcb.kicad_pcb]
2026-02-27 cleaned up some traces
    [battery.kicad_sch, robot_pcb.kicad_pcb]
2026-02-27 fixed some cooked traces
    [robot_pcb.kicad_pcb]
2026-02-27 added some lcsc part ids
    [battery.kicad_sch, pd_ic.kicad_sch, regulator_12v.kicad_sch, regulators.kicad_sch, robot_pcb.kicad_pcb, robot_pcb.kicad_sch]
2026-02-27 more lcsc part labels for non generic components
    [battery.kicad_sch, down_leds.kicad_sch, frontleds.kicad_sch, robot_pcb.kicad_sch]
2026-02-27 more vias
    [robot_pcb.kicad_pcb]
2026-02-28 added schematic for new 12v regulator (no footprints yet)
    [IAUCN04S7L028ATMA1.stp, RHA0040P.stp, regulators.kicad_sch]
2026-02-28 added footprints for new 12v regulator
    [regulators.kicad_sch]
2026-02-28 finished routing for 12v regulator
    [XAL5030-601MEB.stp, regulator_12v.kicad_sch, regulators.kicad_sch, robot_pcb.kicad_sch]
2026-02-28 fixed silkscreen violations
2026-02-28 more vias for better gnd
2026-02-28 added 3d models for most components
    [BNO086.stp, CYPD3175-24LQXQ.stp, IND_CYA0630_SHH.step, IND_TAIYO_NRS8040_TAY.step, POWERPAK_SO-8_SINGLE_VIS.step, SIS443DN-T1-GE3.stp, regulators.kicad_sch]
2026-02-28 added lcsc part numbers for non trivial 12v components
    [regulators.kicad_sch]
2026-02-28 lcsc numbers for other regulators
    [regulators.kicad_sch]
2026-02-28 made one of the traces less ugly
2026-03-04 moved usb c port to edge
    [pd_ic.kicad_sch, robot_pcb.kicad_sch]
2026-03-04 added open pull down resistor to allow disabling usb pd controller
    [pd_ic.kicad_sch]
2026-03-04 probably should have checked clearance
    [regulators.kicad_sch]
2026-03-04 made traces much thicker for power
2026-03-05 converted some power traces to filled zones for better current capabilities
2026-03-06 made some traces go over multiple layers for better thermals
2026-03-09 Updated edge cuts and drawings from earlier fusion changes and moved traces accordingly
    Also fixed jst connectors
    [battery.kicad_sch, frontleds.kicad_sch, robot_pcb.kicad_sch]
2026-03-10 disconnected back tof and rotated button
    [robot_pcb.kicad_sch]
2026-03-10 swapped down led and fan pwm channels
    [robot_pcb.kicad_sch]
2026-03-11 started moving traces to be same distance apart to look cleaner
    [battery.kicad_sch, regulators.kicad_sch]
2026-03-12 more progress on cleaning up traces
2026-03-12 finished fixing trace spacing for all major lines
2026-03-13 hopefully this doesnt mess stuff up
    [frontleds.kicad_pcb, frontleds.kicad_sch]
2026-03-13 front led base layout done, should probably move resistors onto this board
    [LED_Cree-XP-GWT.step, frontleds.kicad_pcb, frontleds.kicad_sch]
2026-03-13 added edge connector sockets to main pcb and changed led power source to 3.3v
    [HSEC8-110-01-S-DV-A.stp, frontleds.kicad_sch, regulators.kicad_sch]
2026-03-13 smol boi
    [frontleds.kicad_pcb, frontleds.kicad_sch]
2026-03-13 changed front leds to use dedicated led current drivers
    [STCS1APUR.stp, frontleds.kicad_pcb, frontleds.kicad_sch]
2026-03-13 tied STCS1A en to pwm
    [frontleds.kicad_sch]
2026-03-13 export steps
    [frontleds.kicad_pcb, frontleds.kicad_sch, frontleds.step]
2026-03-14 moved polyfuse to positive side of battery
    [battery.kicad_sch, frontleds.kicad_sch]
2026-03-14 lcsc part numbers
    [frontleds.kicad_sch]
2026-03-14 small changes to leds
    [frontleds.kicad_pcb, frontleds.kicad_sch]
2026-03-14 step files
    [frontleds.step]
2026-03-14 moved front led connectors to underneath pcb
2026-03-14 increased width of motor power connectors
2026-03-14 added 3d model for polyfuse
    [MF-RG900-0.stp, MF-RG900-2.stp]
2026-03-14 made led 3d model path relative
    [frontleds.kicad_pcb]
2026-03-14 model for a jst connector
    [B2PS-VH_LF__SN_.stp]
2026-03-14 very small change to some trace widths
2026-03-15 fixed some issues with crystals and other stuff
    [battery.kicad_sch, pd_ic.kicad_sch, robot_pcb.kicad_sch]
2026-03-15 replaced tht fets with smd ones in bms
    [battery.kicad_sch]
2026-03-15 increased width of a power filled zone
2026-03-15 more lcsc parts
    [battery.kicad_sch, robot_pcb.kicad_sch]
2026-03-16 more lcsc
    [battery.kicad_sch, frontleds.kicad_sch, pd_ic.kicad_sch, regulators.kicad_sch, robot_pcb.kicad_sch]
2026-03-16 lcsc + changed footprint of a capacitor
    [battery.kicad_sch, regulators.kicad_sch, robot_pcb.kicad_sch]
2026-03-17 lcsc again
    [down_leds.kicad_sch, pd_ic.kicad_sch, regulators.kicad_sch]
2026-03-17 lcsc resistors and capacitors done probably except the 67m one
    [frontleds.kicad_sch]
2026-03-17 standardised components
    [regulators.kicad_sch, robot_pcb.kicad_sch]
2026-03-17 a resistor did a 180 somehow idk
2026-03-17 voltage step up for indicator led logic (all lcsc parts included)
    [robot_pcb.kicad_sch]
2026-03-18 standardised components, removing mixed values
    [battery.kicad_sch, frontleds.kicad_sch, pd_ic.kicad_sch, regulators.kicad_sch, robot_pcb.kicad_sch]
2026-03-18 add bom etc
    [bom.csv, designators.csv, positions.csv]
2026-03-18 made power traces on bms go over multiple layers for better thermals
2026-03-18 removed random bit sticking out from gnd1 power plane
2026-03-18 updated pcb from schematic + prod
    [bom.csv, positions.csv]
2026-03-18 weird 5v zone
2026-03-19 changed leds
    [down_leds.kicad_sch]
2026-03-19 made front leds use 5v instead of batt for efficiency
    [frontleds.kicad_sch]
2026-03-19 lcsc for 68m resistors
    [frontleds.kicad_sch]
2026-03-19 another diode
    [battery.kicad_sch, frontleds.kicad_sch]
2026-03-19 6 pin tof sensors
    [frontleds.kicad_sch, robot_pcb.kicad_sch]
2026-03-19 ALL LCSC PARTS DONE
    [battery.kicad_sch, bom.csv, pd_ic.kicad_sch, positions.csv, regulators.kicad_sch, robot_pcb.kicad_sch]
2026-03-19 Fixed errors with open resistors and led
    [bom.csv, pd_ic.kicad_sch, positions.csv, regulators.kicad_sch, robot_pcb.kicad_sch]
2026-03-19 Production of leds and pcb
    [bom.csv, designators.csv, frontleds.kicad_pcb, frontleds.kicad_sch, positions.csv]
2026-03-19 changed mosfet lcsc part
    [bom.csv, pd_ic.kicad_sch]
2026-03-20 screw holes for display
2026-03-20 aligned motors
    [positions.csv]
2026-03-23 added reset pin to stm32 debug output
    [battery.kicad_sch, down_leds.kicad_sch, frontleds.kicad_sch, pd_ic.kicad_sch, regulators.kicad_sch, robot_pcb.kicad_pcb, robot_pcb.kicad_sch]
2026-03-23 made it not overwrite other changes
    [robot_pcb.kicad_pcb]
2026-03-23 gerber files
    [bom.csv, positions.csv]
2026-03-23 updated pcb from schematic and it pulled some changes that idk if they are fine or not but anyway
    [robot_pcb.kicad_pcb]
2026-03-23 added label for nrst
    [robot_pcb.kicad_pcb]
2026-03-26 changed constraints to 0.16mm clearance for 2oz copper
    [robot_pcb.kicad_pcb]
2026-03-26 fixed 99% of drc errors instead of finishing english
    [robot_pcb.kicad_pcb]
2026-03-27 fix switch2 footprint being incorrect
    [battery.kicad_sch, robot_pcb.kicad_pcb]
2026-03-27 fixed wrong jst connector
    [battery.kicad_sch, robot_pcb.kicad_pcb]
2026-04-23 Marked 19V regulator as DNP to simplify next board iteration
    [regulators.kicad_sch, robot_pcb.kicad_pcb, robot_pcb.kicad_sch]
2026-04-23 changes to fix broken stuff
    [battery.kicad_sch, down_leds.kicad_sch, regulators.kicad_sch, robot_pcb.kicad_pcb]
2026-04-23 switch now bigger
    [battery.kicad_sch, down_leds.kicad_sch, robot_pcb.kicad_pcb, robot_pcb.kicad_sch]
2026-04-23 bro how does this work (fix led symbol footprint and model)
    idk why frontleds can use drylettuce symbols but not footprints/3d models liek whaaaaa
    [frontleds.kicad_pcb, frontleds.kicad_sch]
2026-04-23 reinstated fixed battery schematic
    [battery.kicad_sch, down_leds.kicad_sch]
2026-04-23 Revert "pcb"
    This reverts commit 4408802fdc77718ad8d669ae9eabbe9d43823e20.
    [robot_pcb.kicad_pcb]
2026-04-23 fix pcb
    [robot_pcb.kicad_pcb]
2026-04-24 does this work
    [regulators.kicad_sch, robot_pcb.kicad_pcb]
